Thenine2077/humanoi/docs/AMAZINGHAND.md

# มือ AmazingHand — คู่มือการทำงานและสถานะ

อัปเดต 21 ต.ค. 2026 · มือขวา 8 servo ติดปลายแขนซ้าย (left_link_6) ใช้ในเกมเป่ายิ้งฉุบ ([RPS_GAME.md](RPS_GAME.md))

## สรุปสั้น

| | |
|---|---|
| **ใช้ได้แล้ว** | คุมมือจาก ROS บน Pi, เช็กไฟก่อนขยับ, หา baud เอง, ท่ามือในเกมครบ (ค้อน กระดาษ กรรไกร ง้าง ชูโป้ง ชู 2 นิ้ว ส่ายนิ้ว), เครื่องมือคาลิเบรตทีละนิ้ว, **สอนท่ามือเอง** (`arm hand-teach` จ็อก/ดัดด้วยมือ แล้วบันทึก) ใช้ใน `arm program` / `arm hand` / เกม |
| **ยังติด** | นิ้วมีระยะฟรี, แตร servo น่าจะใส่คลาดหลายฟัน (กำ/แบอาจชนขอบ servo), คาลิเบรตยังไม่เสร็จ, ขีดจำกัด servo ที่อ่านจาก EEPROM ยังไม่ได้ยืนยันกับของจริง |
| **ตอนนี้** | บอร์ดมือเสียบกับ Pi แล้ว (21 ต.ค. บ่าย — แขนซ้าย + Nano + มือ) |

---

## 1. ฮาร์ดแวร์

| ชิ้น | รายละเอียด |
|---|---|
| มือ | AmazingHand (ชุด AliExpress) **มือขวา** 4 นิ้ว |
| servo | Feetech SCS0009 × 8 (model 1284) ลิมิตโรงงาน raw 20–1003 ≈ ±144° |
| ID | นิ้วชี้ 1-2 · กลาง 3-4 · นาง 5-6 · โป้ง 7-8 (ตัวแรกของคู่ = a, ตัวที่สอง = b) |
| บอร์ดต่อ | Waveshare Bus Servo Adapter (A) — CH343 USB `1a86:55d3` serial `5B91044327` · jumper ที่ **B** (USB) |
| พอร์ตบน Pi | `/dev/serial/by-id/usb-1a86_USB_Single_Serial_5B91044327-if00` (เกมหาเองจาก USB ID) |
| baud | ตอนนี้ **250000** (ค่าร้าน) — เคยตั้งเป็น 1 Mbps เมื่อ 29 ก.ย. แต่ 20 ต.ค. เจอกลับเป็น 250000 เอง |
| ไฟ | แหล่งจ่าย **6 V ≥3 A** เข้าช่องไฟของบอร์ด → ที่ servo ได้ 5.1–5.4 V (บอร์ดทำไฟตก ~0.8–1 V) |

**กฎไฟ:** servo **ห้ามเกิน 7.4 V** · บอร์ดเขียนรับ 9–12.6 V แต่ส่งไฟตรงเข้า servo **ห้ามใช้** · ไฟ 5 V ไม่พอ
(servo ได้แค่ 3.9–4.3 V ต่ำกว่า 4.5 V ที่มันยอมทำงาน) · วัดมิเตอร์ที่ช่อง V–G ของบอร์ดก่อนเสียบมือทุกครั้งที่เปลี่ยนแหล่งจ่าย

**ต่อ:** ไฟ 6 V → บอร์ด · jumper B · USB บอร์ด → Pi · เปิดพอร์ตได้ทีละโปรแกรม (เกม / เครื่องมือคาลิเบรต / tools บน Windows)

---

## 2. ซอฟต์แวร์ทำงานยังไง

แพ็กเกจ `ros2_ws/src/humanoi_games` (รันใน container `humanoi_ros` บน Pi)

### amazinghand_node — ตัวคุมมือ (ตัวเดียวที่เปิดพอร์ตมือ)

ตอนเชื่อมต่อทำตามลำดับ ไม่ผ่านขั้นไหน = **ไม่เปิดแรงบิด ไม่ขยับ** แล้วบอกเหตุผลใน log:

1. หาพอร์ตจาก USB ID ของบอร์ด
2. หา baud เอง (ลอง 1 Mbps ก่อน แล้วไล่ค่าอื่น — อ่านอย่างเดียว)
3. servo ต้องตอบครบ 8 ตัว และไฟ **4.8–7.4 V** ทุกตัว
4. อ่านขีดจำกัดมุมจาก EEPROM ของ servo แต่ละตัว (อ่านไม่ได้/ค่าแปลก = ใช้ ±144° แล้วเตือน)
5. สั่งให้ถือท่าปัจจุบันก่อน แล้วค่อยเปิดแรงบิด (นิ้วไม่กระตุก)

หัวข้อ ROS:
- `/hand/gesture` (รับ) ชื่อท่า หรือ `relax` = ปลดแรงบิด · คำสั่งใหม่ตัดท่าเคลื่อนไหวที่ค้างอยู่ทันที
- `/hand/status` (ส่ง) `ready` · `gesture:<ท่า>` · `relaxed` · `error:<เหตุผล>`

เป้าหมายที่เกินขีดจำกัดของ servo ถูกจำกัดไว้ที่ขอบ (เตือนใน log) · ปิดโหนด = ปลดแรงบิดทุกตัว (นิ้วอ่อนลงเป็นกำ)

### มุมนิ้วคิดยังไง

แต่ละนิ้วมี servo 2 ตัว: **หมุนสวนกัน = งอ/เหยียด**, **หมุนไปทางเดียวกัน = เอียง/กาง**

```
servo a = งอ + เอียง + กางเพิ่ม        servo b = -งอ + เอียง + กางเพิ่ม      (องศา)
```

ค่าคาลิเบรตต่อนิ้ว: **แบสุด** (งอตอนแบ), **กำสุด** (งอตอนกำ), **เอียง** (ให้นิ้วตั้งตรง)

### ท่ามือ (`hand_poses.py`)

| ท่า | นิ้วชี้ | นิ้วกลาง | นิ้วนาง | นิ้วโป้ง | ใช้ตอน |
|---|---|---|---|---|---|
| `rock` ค้อน | กำสุด | กำสุด | กำสุด | กำสุด | หุ่นออกค้อน |
| `paper` กระดาษ | แบสุด | แบสุด | แบสุด | แบสุด | หุ่นออกกระดาษ / จบเกม |
| `scissors` กรรไกร | แบ + กาง 25° | แบ − กาง 25° | กำสุด | กำสุด | หุ่นออกกรรไกร |
| `windup` ง้าง | กึ่งกลาง | กึ่งกลาง | กึ่งกลาง | กึ่งกลาง | ตอนเป่า-ยิ้ง |
| `like` ชูโป้ง | กำสุด | กำสุด | กำสุด | แบสุด | หุ่นแพ้ |
| `point` ชี้ | แบสุด | กำสุด | กำสุด | กำสุด | ส่ายนิ้ว |
| `victory` (เคลื่อนไหว) | กรรไกร ↔ หุบ 3 รอบ | | | | — (เกมไม่ได้ใช้แล้ว) |
| `nonono` (เคลื่อนไหว) | ชี้แล้วส่าย ±35° 3 รอบ | | | | หุ่นชนะ / ไม่เห็นมือผู้เล่น |

### hand_calibrate — คาลิเบรตทีละนิ้ว

```bash
arm hand-calibrate            # ปิดเกมก่อน (ใช้พอร์ตเดียวกัน)
arm hand-calibrate --reset    # เริ่มใหม่จากค่าเดโม (ค่าเดิมเปลี่ยนชื่อเป็น .bak-<เวลา>)
```

ตอนเปิดพิมพ์ baud และขีดจำกัดที่อ่านจาก servo ทุกตัว แล้วทีละนิ้ว (นิ้วอื่นกำไว้):

1. **ท่าแบสุด** (เริ่มที่นี่): `+` / `-` แบมาก/น้อย · `l` / `r` เอียงจนนิ้วตั้งตรง
2. กด `c` → **ท่ากำสุด**: `+` / `-` จนปลายนิ้วแตะฝ่ามือพอดี (servo ครางค้าง = เกิน กด `-`)
3. กด `n` → นิ้วถัดไป (บันทึกให้) · `q` บันทึกแล้วออก · `x` ออกไม่บันทึก · ใส่ตัวเลขได้ เช่น `+5`

บรรทัดคำสั่งบอกค่าปัจจุบันและมุม servo จริง เช่น `[นิ้วชี้ · ท่ากำสุด] แบ -94 · กำ +112 · เอียง -20 · servo ID1 +92 ID2 -132`
ถ้าไม่ยอมแก้จะบอกตัวเลข เช่น `servo ID2 ต้องไป -150° แต่หมุนได้ -144..+144°`

ค่าเก็บที่ `/humanoi_ws/src/humanoi_games/config/middle_pos.json` (บน Pi = `~/Humanoi/ros2_ws/src/...`)
— เกมโหลดตอนเปิด (คาลิเบรตแล้วต้องเปิดเกมใหม่) · ไฟล์รูปแบบเก่า (middle_pos) แปลงให้เองโดยท่าไม่เปลี่ยน · ไม่มีไฟล์ = ท่าเหมือนเดโมของ Pollen

### hand_teach — สอนท่ามือเอง (`arm hand-teach`)

ท่าที่คำนวณจากค่าคาลิเบรตดูไม่ดี → จัดท่าเองทีละนิ้วแบบสอนหุ่นยนต์ แล้วบันทึกเป็นชื่อท่า

```bash
arm hand-teach                # บน Pi · ปิด arm player / arm rps / arm hand-calibrate ก่อน (ใช้พอร์ตมือเดียวกัน)
```

| พิมพ์ | ทำอะไร |
|---|---|
| `1` `2` `3` `4` | เลือกนิ้ว ชี้ / กลาง / นาง / โป้ง · `0` = ทุกนิ้ว |
| `+` / `-` | กำ / แบ นิ้วที่เลือก 5° (`+10` = 10°) |
| `l` / `r` | เอียงนิ้วที่เลือก 5° (`l10` = 10°) |
| `free` | ปล่อยนิ้วที่เลือกให้อ่อน — **จับดัดด้วยมือ**ได้ |
| `hold` | ล็อกนิ้วที่ปล่อยไว้ตรงที่ดัด (`save` / จ็อก ล็อกให้เองด้วย) |
| `load <ชื่อ>` | เรียกท่า (ในตัวหรือที่สอนไว้) มาแก้ต่อ — ขยับเร็วเท่าตอนเล่นจริง ใช้ดูว่าใน `arm hand` / เกมจะออกมาแบบไหน |
| `save <ชื่อ>` | บันทึกท่าตอนนี้ · ชื่อภาษาอังกฤษ (a-z 0-9 _) |
| `list` · `del <ชื่อ>` · `q` | ดูท่าที่สอน · ลบ · ออก (นิ้วอ่อนลง) |

- เริ่มที่ท่าที่มือค้างอยู่ตอนเปิด · บรรทัดคำสั่งบอก `ชี้ งอ +20 เอียง +4` ของนิ้วที่เลือก (`(ปล่อย)` = นิ้วอ่อนอยู่)
- **ชื่อเดียวกับท่าในตัว** (`rock` `paper` `scissors` `point` `like` `windup` `victory` `nonono` `fist`) = **ใช้แทนท่าในตัว** ทุกที่ รวมถึงเกมเป่ายิ้งฉุบ · `del` ชื่อนั้น = กลับไปใช้ท่าคำนวณ · `victory` / `nonono` ที่สอนเองเป็นท่านิ่ง
- ชื่อใหม่ (เช่น `ok`, `wave1`) ใช้ใน `arm program` / `arm hand` ได้ทันที · ลบท่าที่ยังใช้ในโปรแกรมไม่ได้
- เก็บใน `programs.yaml` (หัวข้อ `hand_poses` — องศา servo ID 1-8 ตรงๆ) ไฟล์เดียวกับท่าแขน · `arm list` แสดงด้วย
- ตัวคุมมืออ่านไฟล์ใหม่ทุกคำสั่ง — สอนเพิ่มแล้ว**ไม่ต้องรีสตาร์ท** `arm player` / เกม
- ท่าที่สอนเป็นองศา servo ของ**มือตัวนี้** — ถ้าถอดแตร servo ใส่ใหม่หรือเปลี่ยนมือ ต้องสอนใหม่ (ไม่ขึ้นกับค่าคาลิเบรต)
- ถึงขอบที่ servo หมุนได้ (±143) = หยุดที่ขอบแล้วเตือน
- **นิ้วไปต่อไม่ได้** (ชนฝ่ามือ / ชนนิ้วอื่น / สุดทางกลไก) = เตือน `! นิ้วไปต่อไม่ได้: นาง ID5 ค้างที่ +70 (สั่ง +90)` แล้วถือไว้ตรงที่ไปถึง — ท่าที่ `save` จึงเป็นท่าที่นิ้วทำได้จริง เห็นเตือนแล้ว**อย่ากดต่อ**
- ทำไมต้องหยุดดัน: servo ตั้งไว้ว่าโหลดเกิน 80% นานๆ = **ตัดแรงบิดตัวเอง** (unloading condition — อ่านจาก servo 21 ต.ค.) นิ้วนั้นอ่อนไปทุกท่าหลังจากนั้น ท่าเลยดูมั่ว · ตัวคุมมือ (`arm player` / เกม) ก็เช็กแบบเดียวกันทุกท่า: เปิดแรงบิดคืนให้ก่อนทำท่า และนิ้วไหนไปไม่ถึงจะถือไว้ตรงนั้นแล้วเตือนชื่อท่าในหน้าต่าง player
- นิ้วชนฝ่ามือที่ราว ชี้ 106 กลาง 116 นาง 98 โป้ง 122 (วัด 29 ก.ย. เทียบค่ากลางเดโม) — ตัวเลข `งอ` ที่เห็นเป็นมุม servo ดิบ ไม่ใช่มุมนิ้ว แต่ละนิ้วจุดศูนย์ไม่เท่ากัน ดูที่นิ้วจริงเป็นหลัก

### ใช้มือในโปรแกรมแขน (`arm program`)

`arm player` เปิดตัวคุมมือให้ด้วย (ห้ามเปิดพร้อม `arm rps` — ใช้แขนและพอร์ตมือเดียวกัน) แล้วเขียนท่ามือในขั้นของโปรแกรมได้:

```
arm program <ชื่อ> <แขนซ้าย>/<แขนขวา>[/<มือซ้าย>[/<มือขวา>]] ...     (- = ไม่ขยับ, wait=วินาที = รอ)
```

ท่ามือ: `rock` `paper` `scissors` `point` `like` `windup` `victory` `nonono` `fist` `relax` + ท่าที่สอนเอง (`arm hand-teach`)

```bash
arm player                                       # หน้าต่าง 2 (มีตัวคุมมือ) · nohand = ไม่ต่อมือจริง
arm hand rock                                    # ลองท่ามือตรงๆ
arm program grab act1/- -/-/rock act2/-/paper    # แขนไป act1 → มือกำ → แขนไป act2 พร้อมแบมือ
arm show grab                                    # ตารางมีคอลัมน์ มือซ้าย / มือขวา
arm run grab
```

- แขนกับมือในขั้นเดียวกัน**ขยับพร้อมกัน** — อยากให้แขนถึงก่อนแล้วมือค่อยกำ ให้แยกเป็นสองขั้น (`act1/-` แล้ว `-/-/rock`)
- ขั้นถัดไปรอจนแขนถึงและมือทำท่าเสร็จ (ท่านิ่ง 0.6 วินาที, `victory` / `nonono` 1.8 วินาที)
- ช่อง **มือขวา** ทำรอไว้สำหรับมือที่สอง (หัวข้อ `/right_hand/gesture`) — ตอนนี้ยังไม่มีมือ จะเตือนแล้วข้าม
- โปรแกรมเดิม (`<แขนซ้าย>/<แขนขวา>`) ใช้ได้เหมือนเดิม · ในไฟล์ `programs.yaml` ขั้นเป็น `{left: act1, right: still, left_hand: rock}`

### สั่งมือตรงๆ (ทดสอบ)

```bash
docker exec -it humanoi_ros /entrypoint.sh ros2 run humanoi_games amazinghand_node
docker exec humanoi_ros /entrypoint.sh ros2 topic pub --once /hand/gesture std_msgs/msg/String "{data: paper}"
```

เครื่องมือบน Windows (`Desktop\AmazingHand\tools\`, ใช้ตอนเสียบมือเข้า PC): `scan_servos.py` (อ่านอย่างเดียว เช็กไฟ),
`relax.py`, `find_limits.py`, `finger_test.py` — ตั้งค่าเริ่มไว้ 1 Mbps **ต้องใส่ `--baud 250000`** ตอนนี้

---

## 3. ปัญหาที่ยังค้าง

| # | ปัญหา | ผล | ทางแก้ / สถานะ |
|---|---|---|---|
| 1 | **นิ้วมีระยะฟรี** (เจอ 20 ต.ค.) | ตำแหน่งนิ้วไม่ซ้ำเดิม คาลิเบรตแล้วก็ไม่นิ่ง | ขันสกรูแตร servo และข้อต่อก้านนิ้วให้แน่น (ปิดไฟมือก่อน) **ก่อน**คาลิเบรต — ซอฟต์แวร์แก้ไม่ได้ |
| 2 | **แตร servo น่าจะใส่คลาดหลายฟัน** | ท่าตรงของมือนี้ต่างจากมือตัวอย่างมาก (นิ้วกลางต้องงอกลับ ~57°, นิ้วชี้ต้องเอียงเกิน 30°) ช่วงหมุนที่เหลือของ servo น้อย — กำ/แบอาจชนขอบก่อนนิ้วถึง เช่นนิ้วชี้เอียง −20 → servo ID2 ชนขอบที่กำราว +123 | แก้ถาวร: ถอดแตรใส่ใหม่ให้ตรงฟัน (ฟันละ 18°) ค่าคาลิเบรตจะกลับมาใกล้ 0 · ตอนนี้ชดเชยด้วยซอฟต์แวร์ |
| 3 | **คาลิเบรตยังไม่เสร็จ** | ไฟล์ล่าสุด (20 ต.ค. 16:26) = ท่าตรงทุกนิ้ว + กำสุดนิ้วชี้เท่านั้น · ค่าจากรอบหลัง (นิ้วชี้ แบ −94 / กำ +112 / เอียง −20) **ไม่ได้บันทึก** | แก้ข้อ 1 ก่อน แล้วคาลิเบรตใหม่ทั้ง 4 นิ้ว (`--reset` ได้) |
| 4 | ~~ขีดจำกัด servo ที่อ่านจาก EEPROM ยังไม่ได้ยืนยัน~~ | 21 ต.ค. อ่านจากมือจริงได้ −144..+144 ทุกตัว (rustypot 1.13.1 อ่านถูก) | ✓ ปิดแล้ว · แต่ขอบนี้เป็นของ servo ไม่ใช่ของนิ้ว — นิ้วชนก่อนถึงขอบเสมอ (ดู hand_teach) |
| 5 | **baud เปลี่ยนกลับเอง** (1 Mbps → 250000) | เครื่องมือบน Windows ที่ตั้ง 1 Mbps ต่อไม่ติด | โหนด/เครื่องมือบน Pi หาเอง · Windows ใส่ `--baud 250000` · สาเหตุยังไม่ทราบ |
| 6 | **ท่ากรรไกร/ชี้/ส่ายนิ้ว ใช้มุมกางตายตัวของเดโม** (±25°, ±15°, ±35°) | อาจดูไม่สวยกับมือนี้ | ปรับใน `hand_poses.py` หลังคาลิเบรตเสร็จ |
| 7 | **ไฟล์คาลิเบรตอยู่บน Pi เท่านั้น** เป็นของ root ไม่อยู่ใน git | ถ้า SD เสียค่าหาย | สำรองเอง / ดึงกลับ PC ก่อน commit (แบบ programs.yaml) — การ sync จาก PC ไม่ทับไฟล์นี้ |
| 8 | **ไลบรารีลงใน container ที่รันอยู่** (rustypot 1.13.1, mediapipe) | สร้าง container ใหม่ = หาย | `docker/Dockerfile` มีชั้นนี้แล้ว — build image ใหม่ตอนว่าง (คำสั่งลงเองอยู่ใน RPS_GAME.md) |
| 9 | **USB บน Pi เต็ม** (4 ช่อง) | ใช้แขนสองข้าง + มือ + กล้องพร้อมกันไม่ได้ | USB hub มีไฟเลี้ยง · ตอนเล่นเกมใช้แขนซ้าย + Nano + กล้อง + มือ พอดี 4 ช่อง |
| 10 | ตำแหน่ง/มุมยึดมือใน URDF ยังเป็นค่าเดา | มีผลแค่ภาพใน RViz / เช็กชนใน MoveIt | วัดจริงแล้วแก้ใน `ar_dual/urdf` |

---

## 4. ทำถึงไหนแล้ว

| วันที่ | |
|---|---|
| 25 ก.ย. | แกะกล่อง: servo เป็น SCS0009 (บอร์ด YB-MFV02 ที่แถมมาใช้ไม่ได้ — เป็นบอร์ด PWM) |
| 29 ก.ย. | ได้ Waveshare adapter · servo ครบ 8 ตัว ID 1–8 · แก้ไฟตก (ใช้แหล่งจ่ายใหม่) · ตั้ง baud 1 Mbps · เขียน tools (scan, relax, wiggle, finger_test, find_limits, calibrate, rc_jog) · รันเดโมของ Pollen ได้ · วัดมุมนิ้วชนฝ่ามือ (ชี้ 106 กลาง 116 นาง 98 โป้ง 122 เทียบค่ากลางเดโม) · ต่อกล้องมือถือให้มือทำท่าตาม (`Fun thing\robot_hand.py`) |
| 20 ต.ค. | ย้ายมือไป Pi · เขียน `amazinghand_node` (เช็กไฟ, หา baud เอง — เจอ 250000) · เกมเป่ายิ้งฉุบใช้มือจริงได้ · ท่าง้างกำหลวม ค้อนกำสุด · เครื่องมือคาลิเบรตบน Pi (ปรับหลายรอบตามที่ใช้จริง: ขยายช่วง ±60°, รีเซ็ตได้, เหลือแค่ แบสุด/กำสุด/เอียง, อ่านขีดจำกัดจาก servo, แสดงมุม servo จริง) |
| 21 ต.ค. | ท่ามือในโปรแกรมแขน (`arm program` ช่อง 3-4, `arm hand`) · มือใน RViz + มือขวา (ซ้ายกลับด้าน) · **`arm hand-teach`** สอนท่ามือเอง (จ็อก / ปล่อยนิ้วดัดด้วยมือ) ชื่อซ้ำท่าในตัว = ใช้แทน · ลองสอนรอบแรก (wave rock scissors point like) แล้วข้างนอกดูมั่ว: ท่าดันนิ้วเลยที่ไปได้ (กลาง/นางไปถึง ±143 = ขอบ servo) → servo ตัดแรงบิดตัวเอง · เพิ่มเช็กนิ้วไปไม่ถึง (หยุดดัน + เตือน) ทั้งตอนสอนและตอนเล่น, `load` เร็วเท่าตอนเล่น, เปิดแรงบิดคืนทุกท่า |
| ถัดไป | สอน 5 ท่ารอบแรกใหม่ (`load` ทีละท่า → แก้ → `save` ชื่อเดิม) แล้วสอน `paper` `windup` เพิ่ม · ขันนิ้วที่หลวม → เสียบมือกลับเข้า Pi → เปิด `arm hand-calibrate` เช็กบรรทัดขีดจำกัด → คาลิเบรตครบ 4 นิ้ว → ลองในเกม → ปรับท่ากรรไกร/ชี้ถ้าจำเป็น · ระยะยาว: ใส่แตร servo ใหม่ |

---

## 5. ไฟล์ที่เกี่ยวข้อง

| ไฟล์ | |
|---|---|
| `ros2_ws/src/humanoi_games/humanoi_games/amazinghand_node.py` | ตัวคุมมือ |
| `ros2_ws/src/humanoi_games/humanoi_games/hand_poses.py` | ตารางท่ามือ + สูตรคำนวณมุม |
| `ros2_ws/src/humanoi_games/humanoi_games/hand_calibrate.py` | เครื่องมือคาลิเบรต |
| `ros2_ws/src/humanoi_games/humanoi_games/hand_teach.py` | สอนท่ามือเอง |
| `ar_program/config/programs.yaml` (บน Pi) หัวข้อ `hand_poses` | ท่ามือที่สอนเอง |
| `ros2_ws/src/humanoi_games/config/middle_pos.json` (บน Pi) | ค่าคาลิเบรต |
| `docs/RPS_GAME.md` | เกมเป่ายิ้งฉุบ |
| `Desktop\AmazingHand\HANDOFF.md`, `Desktop\AmazingHand\tools\` | งานช่วง ก.ย. บน Windows + เครื่องมือ |
| `Desktop\AmazingHand\repo\` (cad, PythonExample) | ของต้นฉบับ Pollen |
