Thenine2077/humanoi/docs/power_budget.pdf

### สรปุ

กำ ลงัไฟทงั้หนุ่
W ปกติ(รวม) | 170.9 | จากชตี อปุ กรณ์
W สงู สดุ (รวม) | 686.1 | ทกุ อยา่ งท างานหนักพรอ้ มกนั — กรณีแยส่ ดุ
จ านวนคา่ ทยี่ งัตอ้ งวัดจรงิ | 1 | ควรเป็น 0 กอ่ นออกแบบแบต

ไวใ้ชต้ อนออกแบบแบต
แรงดันแบต (V) | 24 | แกไ้ด ้
ประสทิ ธภิ าพ DC-DC เฉลยี่ | 85% | step-down ทั่วไป 80–90%
ความจแุ บต (Ah) | 20 | แกไ้ด ้
ใชไ้ดก้ี่ % ของความจุ | 80% | ไมค่ วรใชจ้นหมด 100%
กระแสจากแบต ปกติ(A) | 8.4
กระแสจากแบต สงู สดุ (A) | 33.6 | BMS ตอ้ งจา่ ยตอ่ เนอื่ งไดม้ ากกวา่ นี้
ใชง้านไดป้ ระมาณ (ชั่วโมง) | 1.9 | คดิ จาก W ปกติ

พอรต์ USB ทตี่ อ้ งตอ่ เขำ้ Pi
Arduino MEGA | 1
D500 LiDAR | 1
Astra Pro | 1
Bus Servo Adapter | 2
AR4 Teensy + Nano (แขนละ 2) | 4
รวม | 9
พอรต์ USB บน Pi 5 | 4
ผล | ตอ้ งใช้USB hub แบบมี ไฟเลยี้ ง

### อปุ กรณ์

อปุ กรณ์ | รบัไฟจำก | V | mA ปกติ (ตอ่ ตวั) | mA สงู สดุ (ตอ่ ตวั) | จำ นวน | W ปกติ (รวม) | W สงู สดุ (รวม) | นบั ใน ยอดรวม | ทมี่ ำของคำ่ | หมำยเหตุ
Motor ZKE2032 | Keyence 24V 6.5A | 24 | 975 | 1,500 | 4 | 93.6 | 144.0 | ใช่ | วดั จรงิ | จอ Keyence วัดรวม 4 ตัวได ้3.9A (÷4 = 975) — จดสภาพตอนวัด: ลอ้บนพนื้ /ยกลอย, ทา่ ไหน, ลกู บดิสดุ ไหม · สงู สดุ 1.5A ตามสเปก
PWM Speed control (HW-687) | Keyence 24V 6.5A | 24 | 0 | 0 | 4 | 0.0 | 0.0 | ไม่ | - | กระแสไหลผา่ นไปมอเตอร์นับในแถวมอเตอรแ์ ลว้
LM2596 (24V → 12V) | Keyence 24V 6.5A | 24 | 175 | 300 | 1 | 4.2 | 7.2 | ใช่ | ประมาณ | ค านวณจากโหลด 12V สองแถวถัดไป ÷ ประสทิ ธภิ าพ 80% (สตู ร ไมต่ อ้ งกรอก)
Encoder YT3806 | LM2596 → 12V | 12 | 50 | 80 | 4 | 2.4 | 3.8 | ไม่ | สเปก | ฉลาก DC 8–24V · ≤80mA ตามรนุ่ ใกลเ้คยี ง · นับรวมในแถว LM2596 แลว้
บอรด์ ออปโต ้DST-1R4P (12V→5V) | LM2596 → 12V | 12 | 40 | 80 | 2 | 1.0 | 1.9 | ไม่ | ประมาณ | LED ฝั่งอนิพุต ~5–10mA ตอ่ ชอ่ ง × 4 ชอ่ ง · นับรวมในแถว LM2596 แลว้
AR4 | อะแดปเตอร์AR4 24V | 24 | 1,000 | 10,000 | 2 | 48.0 | 480.0 | ใช่ | ตอ้ งวดั | 1000 เป็นคา่ เดา — วัดตอนเปิดแขนนงิ่ ๆ และตอนขยับ · สงู สดุ = พกิ ัดอะแดปเตอร์10A
AR4 บอรด์ Teensy 4.1 + Nano (USB) | USB hub (มไีฟเลยี้ ง) | 5 | 150 | 200 | 2 | 1.5 | 2.0 | ใช่ | ประมาณ | แขนละ 2 สาย USB
Raspberry Pi 5 (ตัวเปลา่ ) | แหลง่ จา่ ย Pi 5.1V | 5.1 | 1,000 | 2,000 | 1 | 5.1 | 10.2 | ใช่ | ประมาณ | แหลง่ จา่ ยตอ้ งเป็น 5.1V 5A (USB-C)
Hailo AI HAT | แหลง่ จา่ ย Pi 5.1V | 5.1 | 300 | 500 | 1 | 0.0 | 0.0 | ใช่ | ประมาณ | ถา้ไมไ่ ดต้ ดิ บน Pi ใหแ้กจ้ านวนเป็น 0
Arduino MEGA 2560 | USB hub (มไีฟเลยี้ ง) | 5 | 80 | 100 | 1 | 0.4 | 0.5 | ใช่ | ประมาณ | ไมร่ วม relay (ยา้ย relay ไปแหลง่ จา่ ย 5V แยก)
Flysky FS-SR8 | USB hub (มไีฟเลยี้ ง) | 5 | 50 | 50 | 1 | 0.3 | 0.3 | ใช่ | ประมาณ | รับไฟจากขา 5V ของ Mega ซงึ่ มาจาก USB
D500 LiDAR Kit (STL-19P) | USB hub (มไีฟเลยี้ ง) | 5 | 290 | 290 | 1 | 1.5 | 1.5 | ใช่ | สเปก | Waveshare wiki: 1.45W
Astra Pro Depth Camera | USB hub (มไีฟเลยี้ ง) | 5 | 500 | 500 | 1 | 2.5 | 2.5 | ใช่ | สเปก | Orbbec: ไมเ่ กนิ 2.4–2.5W
Bus Servo Adapter (A) V1.1 + AmazingHand | แหลง่ จา่ ยมอื 6V | 6 | 1,000 | 3,000 | 2 | 12.0 | 36.0 | ใช่ | ประมาณ | มอื ละชดุ · เซอรโ์ ว SCS0009 × 8 · หา้มป้อนเกนิ 7.4V · เซอรโ์ วตอ้ งอา่ น ≥4.8V กอ่ นสงั่ ขยับ
Relay 16 channel | แหลง่ จา่ ย 5V (relay) | 5 | 280 | 300 | 1 | 1.4 | 1.5 | ใช่ | ประมาณ | ~70mA ตอ่ ชอ่ งทตี่ ดิ · ตอนวงิ่ ตดิ พรอ้ มกัน 4 ชอ่ ง (ลอ้ ละ 1)
USB hub (ตัว hub เอง) | USB hub (มไีฟเลยี้ ง) | 5 | 100 | 100 | 1 | 0.5 | 0.5 | ใช่ | ประมาณ | ยังไมไ่ ดซ้ อื้ — ตอ้ งเป็นแบบมอี ะแดปเตอรไ์ ฟของตัวเอง
ฟิวส์+ สวติช์/ E-Stop | - | 0 | 0 | 0 | 1 | 0.0 | 0.0 | ไม่ | - | ไมก่ นิ ไฟ ใสไ่ วใ้หร้ายการครบ
รวม (เฉพำะแถวที่นบั ในยอดรวม = ใช)่ | 170.9 | 686.1

วธิใีช: ้ แกเ้ฉพาะชอ่ งสเีหลอื ง (V, mA, จ านวน) — ชอ่ ง W ค านวณเอง · แถวทกี่ นิ ไฟผา่ นอปุ กรณ์อนื่ แลว้ (เชน่ encoder ผา่ น LM2596) ตัง้ นับในยอดรวม = ไม่ จะไดไ้มน่ ับซา ้

### แหลง่ จา่ ย

แหลง่ จำ่ ย | V | จำ่ ยได้ A ตอ่ ตวั | จำ นวน | จำ่ ยไดร้วม W | โหลดปกติ W | โหลดสงู สดุ W | ใชไ้ป % (สงู สดุ ) | สถำนะ | หมำยเหตุ
Keyence 24V 6.5A | 24 | 6.5 | 1 | 156.0 | 97.8 | 151.2 | 97% | ตงึ | จา่ ยมอเตอร์+ LM2596 · จอแสดงกระแสขาออก
อะแดปเตอร์AR4 24V | 24 | 10 | 2 | 480.0 | 48.0 | 480.0 | 100% | ตงึ | แขนละตัว
LM2596 → 12V | 12 | 2 | 1 | 24.0 | 3.4 | 5.8 | 24% | พอ | พกิดั 3A แตไ่ มม่ ฮีตีซงิกใ์ชต้ อ่ เนอื่ งได ้~2A
แหลง่ จา่ ย Pi 5.1V | 5.1 | 5 | 1 | 25.5 | 5.1 | 10.2 | 40% | พอ | อะแดปเตอร์USB-C 27W
USB hub (มไีฟเลยี้ ง) | 5 | | 1 | 0.0 | 6.6 | 7.2 | | ยังไมม่ ขี อ้ มลู | ยังไมไ่ ดซ้ อื้ — ใส่ A ตามอะแดปเตอรข์ อง hub
แหลง่ จา่ ย 5V (relay) | 5 | | 1 | 0.0 | 1.4 | 1.5 | | ยังไมม่ ขี อ้ มลู | ใส่ A ตามฉลากแหลง่ จา่ ย 5V ทมี่ อี ยู่
แหลง่ จา่ ยมอื 6V | 6 | 3 | 2 | 36.0 | 12.0 | 36.0 | 100% | ตงึ | มอืละตัว · ตอนใชแ้บตเปลยี่ นเป็น step-down ≥5A (XL4015/XL4016)

สถานะ: พอ = ใชไ้มถ่ งึ 80% · ตงึ = 80–100% · ไมพ่ อ = เกนิ 100% (ดจู ากโหลดสงู สดุ ) · ชอื่ ในคอลัมน์A ตอ้ งตรงกบั คอลัมน์รับไฟจาก ในชตี อปุ กรณ์
