Thenine2077/humanoi/ros2_ws/src/humanoi_games/models/README.md

# models

`hand_landmarker.task` — MediaPipe Hand Landmarker (Google), ใช้โดย `rps_vision`
- ที่มา: https://storage.googleapis.com/mediapipe-models/hand_landmarker/hand_landmarker/float16/latest/hand_landmarker.task
  (สำเนาเดียวกับที่ใช้ใน `Desktop\Fun thing`)
- สัญญาอนุญาต: Apache License 2.0
- sha256 `fbc2a30080c3c557093b5ddfc334698132eb341044ccee322ccf8bcf3607cde1`, 7.8 MB
