Thenine2077/humanoi/docs/manual/img/overview-robot-front.png

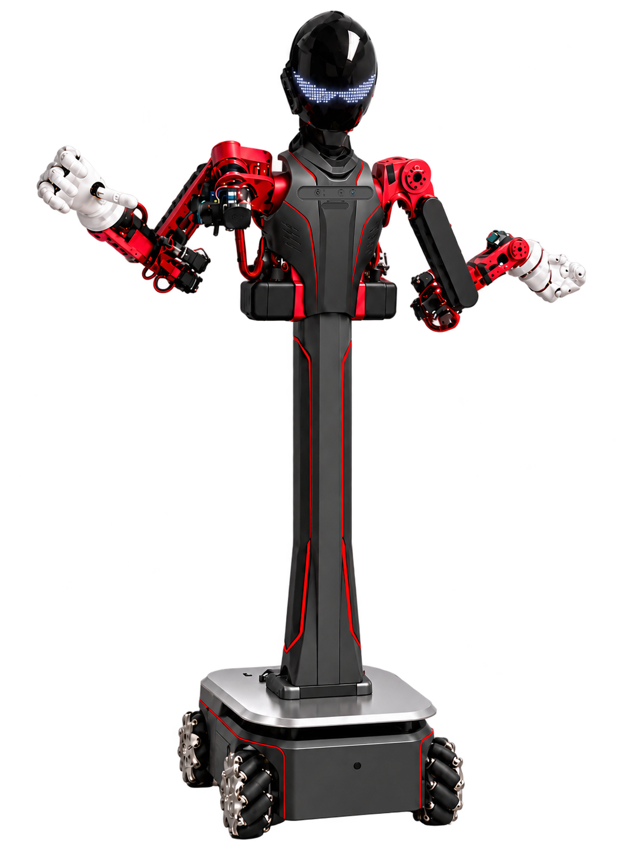
docs/manual/img/overview-robot-front.png
