Thenine2077/humanoi/docs/manual/img/README.txt

รูปสำหรับคู่มือ docs/manual/HUMANOI_MANUAL.html — วางไฟล์ชื่อตามนี้ (.jpg หรือ .png) แล้วเปิดคู่มือใหม่

รูป ปก     cover.jpg                                [รูปถ่าย] หน้าปก
         รูปหุ่นสวยๆ เต็มตัวหรือกำลังทำงาน ภาพแนวตั้งจะพอดีหน้าปกที่สุด
รูป 1.1    overview-robot-front.jpg                 [รูปถ่าย] หุ่น Humanoi ทั้งตัว
         ถ่าย: หุ่นทั้งตัวจากด้านหน้าเฉียง 45° เห็นฐาน แขนสองข้าง มือ และ lidar · ติดป้ายชี้ส่วนประกอบหลัก
รูป 1.3    system-wiring.png                        [แผนผัง] ผังเดินสายทั้งระบบ
         ส่งออกจาก docs/SYSTEM_WIRING.pdf (วาดใน VectorCraft) · แก้ผังแล้วส่งออกใหม่ทับชื่อเดิม
รูป 2.1    safety-exhibition-area.jpg               [รูปถ่าย] การกั้นพื้นที่ในงานจัดแสดง
         ถ่าย: พื้นที่งานจริงที่กั้นเส้นแล้ว เห็นจุด A จุด B ทางวิ่ง และตำแหน่งคนคุมรีโมท
รูป 3.2    pi-connect-terminal.jpg                  [ภาพหน้าจอ] เดสก์ท็อปของ Pi ผ่าน Raspberry Pi Connect พร้อม Terminal
         จับภาพหน้าจอ: หน้าต่าง Screen sharing ของ Raspberry Pi Connect ที่เห็นเดสก์ท็อป Pi · วงกลมไอคอน Terminal (&gt;_) ที่แถบบนซ้าย · มีหน้าต่าง Terminal เปิดอยู่ 1 หน้าต่างพิมพ์ arm status ไว้
รูป 3.3    pi-arm-status.jpg                        [ภาพหน้าจอ] ผลของ arm status ขณะเปิดระบบแขนและตัวเล่นโปรแกรม
         จับภาพหน้าจอ: Terminal บน Pi หลังสั่ง arm status ตอนที่เปิด arm start และ arm player ไว้ · ให้เห็นทั้งบรรทัด ✓ และ ✗ และรายชื่อ controller ท้ายผล · ใช้ Terminal พื้นมืดตัวหนังสือใหญ่พออ่านเมื่อพิมพ์ A4
รูป 3.4    pi-foxglove-connection.jpg               [ภาพหน้าจอ] ต่อ Foxglove บน PC เข้ากับ Pi ที่พอร์ต 8765
         จับภาพหน้าจอ: หน้าต่างเลือกการเชื่อมต่อของ Foxglove บน PC เลือก Foxglove WebSocket ช่อง URL ใส่ ws://EIT-Raspberry-Pi-5.local:8765 · ถ้าได้ ให้ถ่ายคู่กับภาพหลังต่อสำเร็จที่มี Image panel แสดง /tray/image/compressed
รูป 3.5    pi-rebuild-check.jpg                     [ภาพหน้าจอ] ผลของ rebuild_image.sh check เมื่อพร้อมสร้าง image ใหม่
         จับภาพหน้าจอ: Terminal บน Pi หลังสั่ง bash ~/Humanoi/scripts/rebuild_image.sh check · ให้เห็นบรรทัดดิสก์ที่เหลือ, บรรทัด Dockerfile ตรงกับ PC และบรรทัดโปรแกรม ROS ที่รันอยู่
รูป 3.6    pi-usb-devices.jpg                       [รูปถ่าย] Raspberry Pi 5 บนหุ่นและอุปกรณ์ USB ที่ต่ออยู่
         ถ่าย: มุมตรงจากด้านพอร์ต USB ของ Pi 5 (เห็นการ์ด Hailo บนบอร์ดด้วยถ้าทำได้) · ติดป้ายกระดาษที่สายแต่ละเส้น: Teensy แขนซ้าย, Teensy แขนขวา, บอร์ดมือซ้าย/ขวา (Waveshare), กล้อง Astra Pro, Mega ฐานล้อ, lidar · ถ้ามี USB hub ให้เห็นสายไฟเลี้ยงของ hub
รูป 4.1    startup-terminal-windows.jpg             [ภาพหน้าจอ] ตัวอย่างการจัดหน้าต่าง terminal ตอนเล่นภารกิจ
         จับภาพหน้าจอ: หน้าต่าง terminal 6 ช่องที่เปิด arm start / player / tray / lidar / base / mission พร้อมกัน แต่ละช่องเห็นชื่อคำสั่งชัด
รูป 4.2    startup-remote-layout.jpg                [รูปถ่าย] ปุ่มและคันโยกของรีโมทที่ใช้
         ถ่าย: รีโมท FS-ST8 จากด้านหน้า ติดป้าย: คันโยกขวา (เดินหน้า/ถอย, สไลด์), คันโยกซ้าย (หมุน), SWA, SWB, SWD
รูป 5.1    arm-overview-left-right.jpg              [รูปถ่าย] แขนซ้าย (แขน 1) และแขนขวา (แขน 2) เรียกตามด้านของตัวหุ่น
         ถ่าย: หุ่นทั้งตัวจากด้านหลัง (ให้ซ้าย-ขวาของภาพตรงกับซ้าย-ขวาของหุ่น) เห็นแขนทั้งสองบนเสาชัด ติดป้าย "left = แขน 1" ที่แขนซ้าย และ "right = แขน 2" ที่แขนขวา พร้อมลูกศรชี้ทิศ "หน้าหุ่น"
รูป 5.2    arm-joints-j1-j6.jpg                     [แผนผัง] ตำแหน่งข้อต่อ J1–J6 ของแขน AR4 หนึ่งข้าง
         วาด: แขน AR4 หนึ่งข้างแบบเส้นตามที่ติดอยู่บนเสาจริง ระบุ J1 (โคนแขน) J2 (ไหล่) J3 (ศอก) J4 J5 J6 (ข้อมือ) พร้อมลูกศรโค้งบอกแกนหมุนของแต่ละข้อ และวาดมือ AmazingHand ที่ปลาย J6
รูป 5.3    arm-power-switch.jpg                     [รูปถ่าย] สวิตช์ไฟแขน ใช้ตัดไฟเมื่อฉุกเฉิน
         ถ่าย: สวิตช์ไฟแขนบนตัวหุ่น สองภาพ ภาพแรกมุมกว้างให้เห็นว่าอยู่ตรงไหนของหุ่น ภาพที่สองระยะใกล้ให้เห็นตำแหน่งเปิด/ปิด ติดป้าย "สวิตช์ไฟแขน — หยุดฉุกเฉิน"
รูป 5.4    arm-usb-backfeed-check.jpg               [รูปถ่าย] วัดไฟย้อนที่หัว USB-A ของสายแขน ต้องได้ 0V
         ถ่าย: มัลติมิเตอร์ตั้งย่าน DC V สายวัดแตะขาริมสองข้างของหัว USB-A (5V และ GND) หน้าจอมิเตอร์อ่านได้ 0.00 V ระยะใกล้พอเห็นขาในหัว USB ติดป้ายขา "5V" และ "GND"
รูป 5.5    arm-calibrate-limit-switch.jpg           [รูปถ่าย] ลิมิตสวิตช์ของข้อต่อ จุดอ้างอิงตอน calibrate
         ถ่าย: ลิมิตสวิตช์ของข้อต่อหนึ่งข้อ (เช่น J1 ที่โคนแขน) ระยะใกล้ ชี้ให้เห็นตัวสวิตช์และชิ้นส่วนที่หมุนมากดสวิตช์ ติดป้าย "ลิมิตสวิตช์ J1" ถ้าทำได้ ถ่ายอีกภาพของ J6 ด้วย
รูป 5.6    arm-calibrate-output.jpg                 [ภาพหน้าจอ] หน้าจอระหว่าง calibrate แขนซ้ายจนจบ
         จับภาพหน้าจอ: Terminal หลังสั่ง arm calibrate left 6 5 4 1 2 3 จนจบ ให้เห็นกล่องคำเตือน "=== CALIBRATE แขนซ้าย — ลำดับ: 6 5 4 1 2 3 ===" บรรทัด "พร้อมแล้วกด Enter" บรรทัด ✓ J.. เจอสวิตช์แล้ว ครบหกข้อ บรรทัด "calibrate ครบตามที่สั่งแล้ว" บรรทัด → ข้อ .. ไป ... และบรรทัด "เสร็จแล้ว — ..." (ตัดเป็นสองภาพได้ถ้ายาว)
รูป 5.7    arm-start-windows.jpg                    [ภาพหน้าจอ] หน้าต่าง arm start และ arm player ที่เปิดค้างไว้
         จับภาพหน้าจอ: Terminal สองหน้าต่างวางเคียงกัน หน้าต่าง 1 arm start เห็นบรรทัดเช็กค่าชดเชยศูนย์ "... ตรงกับไฟล์ ✓" และ "เปิดระบบแขน (ซ้าย=real @ ... · ขวา=real @ ...)" หน้าต่าง 2 arm player เห็นบรรทัด "เปิดตัวเล่นโปรแกรม speed=0.19 rad/s + ตัวคุมมือ ..." ติดป้าย "หน้าต่าง 1" "หน้าต่าง 2"
รูป 6.1    teach-rviz-joints.jpg                    [ภาพหน้าจอ] RViz กับแผง MotionPlanning: เลือกแขนและเลื่อนมุมข้อต่อ
         จับภาพหน้าจอ: หน้าต่าง RViz เต็มจอบน Pi เห็นโมเดลสองแขน เสา หัว กล้อง และแขนสีส้มโปร่งที่ถูกเลื่อนไว้ต่างจากแขนจริง ไฮไลต์ช่อง Planning Group (เลือก left_arm) และแท็บ Joints ที่มีแถบเลื่อนของแต่ละข้อ ติดป้าย "แขนสีส้ม = ท่าที่จะไป"
รูป 6.2    teach-rviz-plan-execute.jpg              [ภาพหน้าจอ] แท็บ Planning: Velocity Scaling 1.0 ปุ่ม Plan &amp; Execute และปุ่ม Stop
         จับภาพหน้าจอ: แท็บ Planning ของแผง MotionPlanning ระยะใกล้ วงช่อง Velocity Scaling ที่เป็น 1.00 ปุ่ม Plan &amp; Execute และปุ่ม Stop ติดป้ายแต่ละจุด
รูป 6.3    teach-program-timeline.jpg               [แผนผัง] โปรแกรม pick2 เมื่อเล่นจริง: สองแขนเดินไปพร้อมกันทีละขั้น
         วาด: แผนภาพเวลาแนวนอนสองแถว แถวบน "แขนซ้าย" แถวล่าง "แขนขวา" แบ่งเป็น 5 ช่องตามขั้น: 1 rest|rest, 2 act1|act1, 3 act2|แถบจาง "ค้างที่ act1 (-)", 4 กล่อง "wait 1 s" คร่อมสองแถว, 5 rest|rest ระหว่างขั้นวาดเส้นแนวตั้งเขียนว่า "รอทุกแขนถึง" และใส่หมายเหตุใต้ขั้น 3 ว่า "- ไม่ได้กลับ rest"
รูป 6.4    teach-list-output.jpg                    [ภาพหน้าจอ] ผลของ arm list: ท่าของแต่ละแขนและโปรแกรมทั้งหมด
         จับภาพหน้าจอ: Terminal หลังสั่ง arm list เห็นบรรทัดไฟล์ หัวข้อ "ท่าแขนซ้าย (...)" และ "ท่าแขนขวา (...)" พร้อมมุมเป็นองศา และหัวข้อ "โปรแกรม (...)" ที่แสดงขั้นแบบ a/b → c/d ถ้าทำได้ต่อด้วยผล arm show pick2 ด้านล่าง
รูป 6.5    teach-edit-loop.jpg                      [แผนผัง] วงจรแก้ท่า: goto → ปรับใน MoveIt → teach ชื่อเดิม → ลองเล่น
         วาด: วงกลมสี่กล่องต่อกันด้วยลูกศร "arm goto left act1" → "ปรับใน MoveIt (Joints → Plan &amp; Execute)" → "arm teach left act1 (ชื่อเดิม ทับของเดิม)" → "arm run pick2 (ช้าๆ)" แล้ววนกลับกล่องแรก ใส่ข้อความข้างวงว่า "ทุกโปรแกรมที่ใช้ act1 ได้ค่าใหม่ทันที ไม่ต้องรีสตาร์ท"
รูป 6.6    teach-remote-switches.jpg                [รูปถ่าย] สวิตช์บนรีโมท FlySky ที่ใช้สั่งแขน
         ถ่าย: รีโมท FlySky FS-ST8 จากด้านหน้า เห็นสวิตช์ด้านบนทั้งหมด ติดป้ายสวิตช์ที่สั่ง "เล่นโปรแกรม" (ตัวที่ตั้งเป็นช่อง CH6 — SWB หรือ SWC ตามที่ตั้งจริง) "SWD = หยุดแขน" และ "SWA = ARM ล้อ" พร้อมลูกศรบอกทิศ ขึ้น/ลง
รูป 6.7    teach-remote-window.jpg                  [ภาพหน้าจอ] หน้าต่าง arm remote ขณะโยกสวิตช์
         จับภาพหน้าจอ: Terminal ที่เปิด arm remote แล้วโยกสวิตช์จริง ให้เห็นบรรทัด "SWB โยกลง = เล่นโปรแกรม '1' · SWD โยกลง = หยุดแขน" บรรทัด "สวิตช์ SWB=U SWD=U" "สวิตช์ SWB=D SWD=U" "SWB โยกลง -&gt; เล่นโปรแกรม '1'" และ "แขนรายงาน: 1:ok"
รูป 7.1    hand-closeup.jpg                         [รูปถ่าย] มือ AmazingHand ที่ปลายแขน AR4
         รูปถ่ายระยะใกล้ของมือบนปลายแขน เห็นนิ้วทั้งสี่ (ชี้ กลาง นาง โป้ง) และจุดที่ต่อกับข้อ 6
รูป 7.2    hand-servo-ids.jpg                       [แผนผัง] หมายเลข servo ของแต่ละนิ้ว และการหมุนที่ทำให้นิ้วงอหรือเอียง
         วาด: มือมองจากด้านฝ่ามือ ติดเลข ID 1–8 ที่ servo คู่ของแต่ละนิ้ว (ชี้ 1-2, กลาง 3-4, นาง 5-6, โป้ง 7-8) · ภาพเล็กด้านข้างสองภาพ: ลูกศร a กับ b หมุนสวนกัน = นิ้วงอ/เหยียด, ลูกศร a กับ b หมุนทางเดียวกัน = นิ้วเอียง/กาง
รูป 7.3    hand-board-labels.jpg                    [รูปถ่าย] บอร์ด Waveshare Bus Servo Adapter (A) และจุดที่ต้องรู้
         ถ่าย: บอร์ดมองจากด้านบน ตรงๆ แสงพอ · ติดป้าย: ช่องไฟเข้า (6 V), jumper ที่ตำแหน่ง B, ขั้ว V–G สำหรับวัดไฟ, ช่องสาย servo (D V G), พอร์ต USB · แปะสติกเกอร์บนบอร์ดจริงบอกว่าเป็นของแขนไหนพร้อมหมายเลขบอร์ด แล้วให้เห็นในรูป · ถ่ายอีกภาพเป็นมิเตอร์กำลังวัดที่ V–G
รูป 7.4    hand-scan-output.jpg                     [ภาพหน้าจอ] ผลของ arm hand-scan เมื่อมือทั้งสองข้างพร้อมใช้งาน
         จับภาพหน้าจอ: Terminal บน Pi หลังสั่ง arm hand-scan ขณะเสียบบอร์ดมือทั้งสองบอร์ด · ให้เห็นบรรทัดหมายเลขบอร์ด + "มือแขนซ้าย/ขวา", บรรทัด ✓ baud พร้อม ID1–ID8 และค่าไฟ, และบรรทัดสรุปช่วงไฟปลอดภัยท้ายผล · วงสีค่าไฟของ servo หนึ่งตัวไว้อธิบาย
รูป 7.5    hand-builtin-poses.jpg                   [รูปถ่าย] ท่าในตัวของมือ
         ถ่าย: ภาพชุด 8 ช่องเรียงเป็นตาราง 4×2 ฉากหลังเรียบ มุมเดียวกันทุกภาพ (ด้านหน้ามือ ระดับสายตา) ท่า rock, paper, scissors, windup, like, point, victory (จังหวะชูสองนิ้ว), nonono (จังหวะชี้) · ใส่ชื่อท่าใต้แต่ละช่อง · ถ่ายหลังคาลิเบรตเสร็จแล้ว
รูป 7.6    hand-teach-terminal.jpg                  [ภาพหน้าจอ] หน้าต่าง arm hand-teach ระหว่างจัดท่า
         จับภาพหน้าจอ: Terminal บน Pi ระหว่าง arm hand-teach · ให้เห็นบรรทัดช่วยเหลือตอนเปิด, การเลือกนิ้ว 1, คำสั่ง +10, บรรทัดสถานะ "ชี้ งอ … เอียง …", และคำสั่ง save ที่สำเร็จ · ถ้าจับได้ ให้มีบรรทัดเตือน "! นิ้วไปต่อไม่ได้" หนึ่งบรรทัดไว้อธิบาย
รูป 8.1    tray-marker-on-box.jpg                   [รูปถ่าย] ป้าย ArUco id 1 แปะกลางพื้นกล่อง หันด้านบนเข้าหาหุ่น
         ถ่าย: มุมสูงมองลงในกล่อง เห็นทั้งกล่องและป้าย · ใส่ลูกศรบอก "ทางหุ่น" ชี้ไปด้านบนของป้าย · ใส่เส้นบอกขนาด 120 mm ที่ด้านดำ และวงหูกล่องด้านยาวทั้งสองข้าง · ถ้าบนโต๊ะมีเทปหรือที่กั้นตำแหน่งกล่อง ให้เห็นในรูปด้วย
รูป 8.2    tray-detector-view.jpg                   [ภาพหน้าจอ] ภาพจาก arm tray ใน Foxglove: กรอบป้าย แกน และตัวเลขความนิ่ง
         ภาพจาก /tray/image/compressed บรรทัดบน: OK, frames, spread, ตำแหน่งเทียบแขน (arm), ระยะ (dist), reproj
รูป 8.3    tray-teach-touches.jpg                   [แผนผัง] ท่าแตะ: เลื่อนกล่องสองทิศ ข้อมือมุมเดิมทุกครั้ง
         วาด: มุมมองจากด้านบน กล่องตำแหน่งปกติ (เส้นทึบ) และตำแหน่งที่เลื่อนไป 4–5 ตำแหน่ง (เส้นประ) ห่างกัน 3–7 cm ทั้งแนวซ้าย-ขวาและหน้า-หลัง ทุกกล่องหันมุมเดียวกัน · จุดแตะสีแดงที่ตำแหน่งเดียวกันบนกล่องทุกกล่อง · มุมภาพมีปลายนิ้ว/ข้อมือวาดในทิศเดิมทุกครั้ง พร้อมข้อความ "ข้อมือมุมเดิม" และ "ไม่หมุนกล่อง"
รูป 8.4    tray-grip-handle.jpg                     [รูปถ่าย] ท่าจับจริง: นิ้วท่า tray_grip จับหูกล่อง
         ถ่าย: มุมข้างระดับขอบกล่อง ใกล้พอเห็นนิ้วเกี่ยวหูกล่องด้านยาว · ถ่ายคู่อีกภาพเป็นท่า tray_grip0 (นิ้วเตรียม ก่อนจับ) ในมุมเดียวกัน · วางคู่ซ้าย-ขวาพร้อมชื่อท่า
รูป 8.5    tray-pick-sequence.jpg                   [แผนผัง] ลำดับการหยิบห้าขั้นของ arm tray-pick
         วาด: มุมมองด้านข้าง 5 ช่องเรียงซ้ายไปขวา (1) นิ้ว tray_grip0 (2) ข้อมือไปรอเหนือที่จับ 8 cm (3) ลงเส้นตรงตั้งฉากพื้นกล่อง (ลูกศรลง) (4) นิ้ว tray_grip จับหู (5) ยกขึ้นเส้นตรงแล้วค้าง (ลูกศรขึ้น ราว 9–10 cm) · ช่องเล็กท้ายภาพแสดงการวางคืน r ย้อนลำดับ
รูป 8.6    tray-pick-plan.jpg                       [ภาพหน้าจอ] หน้าต่าง arm tray-pick หลังกด Enter: แผนและคำถามยืนยัน
         จับภาพหน้าจอ: Terminal บน Pi ระหว่าง arm tray-pick หลังกด Enter ให้เห็นข้อความแผน และบรรทัด "หยิบเลย? พิมพ์ y แล้ว Enter" · ถ้าได้ ให้ถ่ายอีกภาพเป็นข้อความปฏิเสธ (เช่นกล่องเลื่อนเกิน) ไว้ประกอบหัวข้อเหตุที่ไม่หยิบ
รูป 9.2    base-mega-wiring.jpg                     [รูปถ่าย] Arduino Mega และสายที่ต่อ
         ถ่าย: Mega จากด้านบน เห็นสาย relay (22–29), สายรีโมท (2–9) และสาย encoder (A8–A14) ติดป้ายกลุ่มสาย
รูป 9.3    base-relay-hw687.jpg                     [รูปถ่าย] บอร์ด relay และลูกบิดความเร็ว HW-687 ของแต่ละล้อ
         ถ่าย: บอร์ด relay 8 ช่อง + HW-687 สี่ตัว ติดป้ายว่าลูกบิดไหนคือล้อ FL FR RL RR
รูป 9.4    base-opto-board.jpg                      [รูปถ่าย] บอร์ด opto PC817 ที่แปลงสัญญาณ encoder ให้ Mega
         ถ่าย: บอร์ด opto ใกล้ๆ เห็นขา IN/G ฝั่ง encoder และ V/G ฝั่ง Mega ติดป้ายช่อง 1–4
รูป 9.5    base-wheel-tune-output.jpg               [ภาพหน้าจอ] หน้าจอ wheel-tune ระหว่างจูน
         จับภาพหน้าจอ: arm wheel-tune ที่มีล้อขึ้น ✓ บางล้อ และ เพิ่ม/ลด บางล้อ
รูป 10.1   lidar-mount.jpg                          [รูปถ่าย] lidar บนแผ่นฐานและเสาที่อยู่ข้างหลัง
         ถ่าย: lidar จากด้านข้างและด้านบน เห็นระยะถึงขอบแผ่นหน้า และเสาลำตัวที่อยู่ข้างหลัง
รูป 10.2   lidar-check-bottle.jpg                   [แผนผัง] วางขวดสำหรับ lidar-check
         วาด: ภาพมองจากบน ขวดอยู่หน้าหุ่น 1 m ตรงแนวกลาง (ตลับเมตรจากมุมหน้าซ้าย/ขวาเท่ากัน) และตำแหน่งที่สองข้างซ้ายของหุ่น
รูป 10.3   lidar-foxglove-map.jpg                   [ภาพหน้าจอ] แผนที่ระหว่างทำใน Foxglove
         จับภาพหน้าจอ: Foxglove panel 3D เห็น /map สีเทา จุด /scan และตำแหน่งหุ่น
รูป 11.2   guard-stop-test.jpg                      [รูปถ่าย] ทดสอบกันชน: คนยืนหน้าหุ่น
         ถ่าย: หุ่นหยุดหน้าคน เห็นตลับเมตรวัดระยะจากขอบหน้าฐานถึงหน้าแข้งและปลายเท้า
รูป 12.2   mission-demo-run.jpg                     [รูปถ่าย] ภารกิจ demo_ab ระหว่างฐานวิ่งไป B
         ถ่าย: หุ่นถือกล่องแขนพับ กำลังวิ่งจาก A ไป B เห็นป้าย A และ B บนพื้น
รูป 13.1   rps-setup-overview.jpg                   [รูปถ่าย] การจัดวางสำหรับเกม: หุ่นในท่าตั้ง rps_ready และตำแหน่งผู้เล่น
         ถ่าย: มุมเฉียงจากด้านข้างหุ่น เห็นแขนซ้ายในท่า rps_ready มือท่า windup อยู่หน้ากล้อง, กล้อง Astra บนเสา, โต๊ะหน้าหุ่น และผู้เล่นยื่นมือเหนือโต๊ะ · ถ้ามีจอ HUD ให้เห็นจอด้วย · ติดป้าย: กล้อง, ท่าตั้ง, จุดยื่นมือของผู้เล่น, สวิตช์ไฟแขน
รูป 13.2   rps-round-flow.jpg                       [แผนผัง] ลำดับของหนึ่งตาในเกมเป่ายิ้งฉุบ
         วาด: แผนผังวงรอบ: rps_ready (windup) → เป่า-ยิ้ง-ฉุบ (J1 ขึ้นลง 3 ครั้ง) → ฉุบ (มือออกท่า) → กล้องอ่าน 1.2 s → แยก 4 ทาง: ผู้เล่นชนะ (victory_pose + like), ผู้เล่นแพ้ (lose_pose + nonono), เสมอ (วนกลับไปเป่าใหม่ ≤ 2 ครั้ง), ไม่เห็นมือ (nonono) → ค้าง 3 s แบมือ → กลับผ่าน move_readyP1 → move_readyP2 → rps_ready → รอนิ้วชี้ ≤ 60 s → วนรอบใหม่
รูป 13.3   rps-terminal-windows.jpg                 [ภาพหน้าจอ] สามหน้าต่างของเกม: arm start, arm rps และ arm rps play
         จับภาพหน้าจอ: จัด Terminal 3 หน้าต่างเรียงกันบนจอเดียว (ใส่หัวหน้าต่าง 1/2/3) · หน้าต่าง 3 ให้เห็นบรรทัด "เป่า-ยิ้ง-ฉุบ! ..." และบรรทัดผล "หุ่น: … · ผู้เล่น: … → …" · หน้าต่าง 2 ให้เห็น log บรรทัด "ยกขึ้น = ข้อ 1 …"
รูป 13.4   rps-player-gestures.jpg                  [รูปถ่าย] ท่ามือผู้เล่นที่กล้องอ่านได้ดี
         ถ่าย: จากมุมของกล้องบนเสา (หรือจับจากภาพ /rps/vision/image/compressed) 4 ภาพเรียงกัน: ค้อน, กระดาษ, กรรไกร (ชี้+กลาง), ชูนิ้วชี้ (เล่นใหม่) · ฝ่ามือหันเข้ากล้อง มือเหนือโต๊ะ · เพิ่มภาพที่ห้าเป็นตัวอย่างผิด: มือหันข้าง (ใส่กากบาท)
รูป 13.5   rps-foxglove-hud.jpg                     [ภาพหน้าจอ] Foxglove สอง panel: จอ HUD และภาพที่กล้องอ่านมือ
         จับภาพหน้าจอ: Foxglove บน PC แบ่งจอสองส่วน ซ้าย Image panel /rps/hud/image/compressed ขณะขึ้น YOU WIN! หรือนับ 3-2-1, ขวา Image panel /rps/vision/image/compressed เห็นมือผู้เล่น · ให้เห็นชื่อ topic ที่หัว panel และคะแนนสะสมมุมขวาบนของ HUD
รูป 13.6   rps-show-poses.jpg                       [รูปถ่าย] ท่าโชว์: victory_pose กับมือชูนิ้วโป้ง และ lose_pose กับมือส่ายนิ้ว
         ถ่าย: สองภาพคู่ มุมเดียวกัน (หน้าหุ่นเฉียงเล็กน้อย เห็นทั้งแขนซ้าย) ภาพซ้ายแขนใน victory_pose มือท่า like · ภาพขวาแขนใน lose_pose มือท่า nonono (จังหวะนิ้วชี้เอียง) · ใส่ชื่อท่าใต้ภาพ
