Thenine2077/humanoi/docs/wiring_encoders.md

# Encoder 4 ล้อ → Arduino Mega → ROS

ความเร็วล้อตั้งด้วยลูกบิด HW-687 ล้อละตัว (relay คุมแค่เดิน/ถอย/หยุด) — encoder ไม่ได้คุมความเร็ว
แต่ใช้ **จูนลูกบิดให้ 4 ล้อหมุนเท่ากัน** แล้วปล่อยไว้ และส่ง **feedback ล้อเข้า ROS** (`/wheel_states`, `/wheel_odom`)

```
encoder YT3806 ×4 ──(A/B)──> Mega A8-A15 ──USB "ENC ..."──> relay_bridge (Pi) ──> /wheel_states /wheel_odom /encoder_raw
                                                   <──"W F F F F"──  /cmd_vel หรือ /wheel_cmd (wheel_tune)
```

เฟิร์มแวร์: `firmware/humanoi_base_mega` (ตัวเดิม + encoder) · โหนด: `humanoi_base/relay_bridge.py`, `wheel_tune.py`
ค่าฐาน: `ros2_ws/src/humanoi_base/config/base.yaml`

## ต่อสาย — บอร์ด opto 4 ช่องแผ่นเดียว (ตอนนี้ใช้แบบนี้)

ต่อแค่ **สาย A (เขียว)** ของ encoder ทุกตัว = 4 ช่องพอดี · สายขาว (B) ไม่ต้องต่อ — พันเทปปลายสายกันแตะอะไร
เฟิร์มแวร์ (`ENC_B_WIRED = false`) นับทุกขอบของ A = 720 ต่อรอบ และเอาทิศจากคำสั่ง relay ของล้อนั้นเอง
(สั่งเดินหน้า = นับบวก, สั่งถอย = นับลบ, หยุดแล้วล้อไหลต่อ = ทิศเดิม) — ข้อจำกัด: ล้อถูกดันด้วยมือตอนหยุด ทิศอาจผิด

| บอร์ด opto | ต่อกับ | | บอร์ด opto | ต่อกับ |
|---|---|---|---|---|
| IN1 | E1 (FL) สายเขียว | | OUT1 | Mega A8 |
| IN2 | E2 (FR) สายเขียว | | OUT2 | Mega A10 |
| IN3 | E3 (RL) สายเขียว | | OUT3 | Mega A12 |
| IN4 | E4 (RR) สายเขียว | | OUT4 | Mega A14 |
| G | สายดำ encoder (ลบ 24V) | | VCC / GND | Mega 5V / GND |

> ฐานจริง (wheel-check 28 ต.ค.): สาย FL กับ RR สลับกัน — FL = E4 (A14), FR = E2, RL = E3, RR = E1 (A8)
> → `encoder_map: [3, 1, 2, 0]` ใน `base.yaml` แล้ว ไม่ต้องย้ายสาย

- **แรงดันอินพุตของบอร์ดต้องตรงกับไฟเลี้ยง encoder** (ดูที่พิมพ์บนบอร์ด): รุ่น 24V = เลี้ยง encoder 24V ·
  รุ่น 12V = เลี้ยง encoder 12V ด้วย XL4016 · รุ่น 5V/3.3V ใช้ไม่ได้ (ไฟ LED ในบอร์ดขาด)
- opto บางรุ่นกลับสัญญาณ (เข้าสูง ออกต่ำ) — ไม่เป็นไร นับขอบขึ้น-ลงเหมือนกัน
- อยากได้ทิศจาก encoder จริง (เช่นล้อถูกดัน): เพิ่ม opto อีกแผ่นต่อสายขาว -> A9 A11 A13 A15 แล้วตั้ง
  `ENC_B_WIRED = true` แฟลชใหม่ และ `counts_per_rev: 1440` ใน base.yaml

## ต่อสาย — แบบสาย A+B (ต้องมี opto 8 ช่อง)

| encoder | ล้อ (ตั้งใจ) | A (เขียว) | B (ขาว) | แดง | ดำ |
|---|---|---|---|---|---|
| E1 | FL หน้าซ้าย | A8 | A9 | +24V | GND |
| E2 | FR หน้าขวา | A10 | A11 | +24V | GND |
| E3 | RL หลังซ้าย | A12 | A13 | +24V | GND |
| E4 | RR หลังขวา | A14 | A15 | +24V | GND |

- **ไฟ encoder:** เลี้ยง 24V จากบัสตรงๆ (ผ่านฟิวส์) ทั้ง 4 ตัว — ห้ามใช้ 5V ของ Mega (encoder ต้องการ 8V ขึ้นไป)
  **GND ของ encoder (สายดำ), บัส 24V (−) และ Mega ต้องต่อร่วมกัน**
- **สายสัญญาณ (เขียว/ขาว) ห้ามผ่าน step-down (เช่น XL4016)** — step-down ปล่อยไฟนิ่ง ตัวเก็บประจุในตัวกลืนพัลส์จนนับไม่ได้
  ลดแรงดันสัญญาณด้วยตัวต้านทานแบ่งแรงดัน (หรือบอร์ด opto) แทน

### สัญญาณ: ตัวแบ่งแรงดัน 10kΩ + 2.2kΩ ต่อสายละชุด (8 ชุด)

```
สายเขียว (A) ──[10kΩ]──┬──> ขา Mega (E1 = A8)
                       └─[2.2kΩ]──> GND
สายขาว (B)   ──[10kΩ]──┬──> ขา Mega (E1 = A9)
                       └─[2.2kΩ]──> GND
```

24V × 2.2k / 12.2k ≈ 4.3V — ไม่เกิน 5V ของ Mega และสูงพอให้อ่านเป็น HIGH (ต้องการ ≥ 3V)

- encoder แบบปล่อยแรงดัน (สัญญาณสลับ 0 ↔ 24V) → ใช้ตัวแบ่งนี้
- encoder แบบ **NPN open collector** (ดึงลง GND อย่างเดียว ไม่ปล่อยไฟออก) → ตัวแบ่งทำให้ Mega เห็น LOW ตลอด
  นับไม่ขึ้นเลย (ไม่เสียหาย) → ถอดตัวแบ่ง ต่อสายตรงเข้า Mega ได้ (Mega มี pull-up 5V ในตัว)
- ไม่รู้ว่าเป็นแบบไหน: ใส่ตัวแบ่งไว้ก่อน ปลอดภัยทั้งสองแบบ
- ต่อผิดล้อหรือนับกลับทิศ **ไม่ต้องย้ายสาย** — `arm wheel-check` หาค่า `encoder_map` / `encoder_signs` ให้
- สายสัญญาณเดินห่างสายมอเตอร์/relay ถ้าทำได้ (สัญญาณรบกวนทำให้นับพลาด)

### เช็กชนิดขาออกด้วยมิเตอร์ (ถ้าอยากรู้ก่อนต่อ)

จ่ายไฟ 24V ให้ encoder **โดยยังไม่ต่อสายเขียว/ขาวเข้า Mega** วัดสายเขียว ↔ GND แล้วค่อยๆ หมุนแกน
- ~0V ตลอด = NPN open collector → ต่อตรงเข้า Mega ได้ ไม่ต้องใช้ตัวแบ่ง
- สลับ 0 ↔ 24V = ปล่อยแรงดัน → ต้องใช้ตัวแบ่ง 10k/2.2k ข้างบน

(ทางเลือกแทนตัวแบ่ง: บอร์ด opto 4 ช่อง รุ่นรับ 24V — 8 สาย ใช้ 2 บอร์ด ฝั่งออกต่อ A8–A15 + GND ของ Mega)

### นับยังไง

จานในตัว encoder มี 360 ช่อง แสงลอดช่องทีไร สาย A, B สลับสูง/ต่ำ (A กับ B เหลื่อมกันครึ่งจังหวะ)
Mega นับทุกขอบขึ้น/ลงของทั้ง A และ B = 360 × 4 = 1440 ครั้งต่อรอบ · ทิศดูจากว่า A หรือ B เปลี่ยนก่อน
rpm = Δค่านับ / 1440 / Δt(วินาที) × 60 · ระยะ = รอบ × π × 0.15 m

## แฟลชเฟิร์มแวร์

Mega ตอนนี้เสียบอยู่ที่ Pi — ย้าย USB มาเสียบ PC แล้วอัปโหลดด้วย Arduino IDE (บอร์ด Arduino Mega 2560)
**ปิดไฟมอเตอร์ก่อนอัปโหลด** (relay อาจกระตุกตอนรีเซ็ต) เสร็จแล้วเสียบกลับ Pi

เปิด Serial Monitor 115200 ดูได้เลย: บรรทัดแรก `READY humanoi_base_mega enc=x4` แล้วมี `ENC ...` ทุก 50 ms
หมุนล้อด้วยมือ ค่านับของ encoder ล้อนั้นต้องเปลี่ยน · ตัวเลข 4 ตัวท้าย (นับพลาด) ควรเป็น 0

## ขั้นตอนครั้งแรก

1. **ยกฐานให้ล้อลอยพ้นพื้น** (วางบนกล่อง)
2. หน้าต่าง 1: `arm base noguard` — เปิดค้างไว้ (ยกล้อไม่ต้องใช้ lidar · `arm base` เฉยๆ = กันชน lidar เปิด
   ไม่มี lidar ล้อไม่หมุน — ดู docs/BASE_SAFETY.md)
3. เปิดรีโมท, **SWA ลง**, ปล่อยคันโยก (Mega อยู่โหมด ROS)
4. หน้าต่าง 2: `arm wheel-check`
   - หมุนทีละล้อ FL → FR → RL → RR ล้อละ 2 วิ แล้วถามว่าล้อหมุนไปทางเดินหน้าไหม (ดูด้วยตา ตอบ y/n)
   - ได้ `encoder_map` / `encoder_signs` → ตอบ y บันทึกลง `base.yaml` → **ปิด/เปิด `arm base` ใหม่**
   - ล้อไหนหมุนกลับทาง → แก้ `INVERT` ในเฟิร์มแวร์ (ค่า encoder ที่ได้ใช้ต่อได้)
5. `arm wheel-tune` — 4 ล้อหมุนเดินหน้าค้าง แสดงทุกวินาที เช่น
   ```
   [  5s] FL   60.1 ( -0.4% ✓)  FR   64.0 ( +6.0% ลด)  RL   57.0 ( -5.6% เพิ่ม)  RR   60.5 ( +0.2% ✓)  | เฉลี่ย 60.4 rpm ต่างสุด 11.6%
   ```
   ปรับลูกบิด HW-687 ของล้อที่ขึ้น `ลด` / `เพิ่ม` ทีละนิด รอ 2–3 วิ จนทุกล้อเป็น ✓ (ต่างไม่เกิน ±1.5%) แล้ว Ctrl+C
   - อยากได้ความเร็วตามที่กำหนด: `arm wheel-tune 60` (เทียบกับ 60 rpm แทนค่าเฉลี่ย)
6. `arm wheel-tune back` — เช็กตอนถอยหลังด้วย (มอเตอร์บางตัวเดิน/ถอยเร็วไม่เท่ากัน)
7. วางลงพื้นแล้วเช็กอีกรอบสั้นๆ (มีน้ำหนักกด ความเร็วเปลี่ยน): ขับตรง 2–3 m ดู `/wheel_states`
   หรือ `ros2 run humanoi_base wheel_tune tune --seconds 4` บนพื้นที่โล่ง

## ค่าที่ต้องรู้ก่อนใช้ odometry (`/wheel_odom`)

- `counts_per_rev` = ค่านับต่อ **รอบล้อ** — 1440 ถ้า encoder หมุนรอบเดียวกับล้อ (ต่อแกนตรง)
  ถ้ามีเฟือง/สายพานทดระหว่าง encoder กับล้อ วัดเอง: ทำเครื่องหมายที่ล้อ, `ros2 topic echo /encoder_raw`,
  หมุนล้อด้วยมือ 1 รอบพอดี → ค่านับที่เปลี่ยน = counts_per_rev
- `track` / `wheelbase` / `wheel_radius` ใน `base.yaml` = 0.385 / 0.385 / 0.0725 m (วัด 28 ต.ค.: กว้างนอกล้อ 42.5, ยาว 53, ล้อหนา 4, Ø14.5 cm)
- mecanum ลื่นตอนสไลด์/หมุน odometry จากล้ออย่างเดียวคลาดได้ — ต่อไปค่อยรวมกับ lidar (rf2o) / IMU
  `publish_odom_tf` ปิดไว้ ไม่ให้ชนกับ TF ของ rf2o

## แก้ปัญหา

| อาการ | ดู |
|---|---|
| `wheel-check` บอกไม่มี encoder ไหนนับ | ล้อหมุนไหม — ไม่หมุน = relay/ไฟมอเตอร์/ลูกบิด · หมุน = encoder ไม่มีไฟ 12V / GND ไม่ร่วม / สายหลุด |
| encoder ตัวอื่นนับด้วย | สาย A/B ข้ามล้อ หรือสัญญาณรบกวนจากสายมอเตอร์ |
| `นับพลาด` ขึ้นตอนหมุนเร็ว | สัญญาณช้า (บอร์ด opto) หรือรบกวน → ตั้ง `ENC_EDGES = 2` ในเฟิร์มแวร์ (แล้ว counts_per_rev = 720) |
| `Mega อยู่โหมด RC / DISARMED / NO_SIGNAL` | รีโมทต้องเปิด, SWA ลง, ไม่จับคันโยก |
| rpm ของล้อติดลบตอนเดินหน้า | `encoder_signs` ยังไม่ได้ตั้ง → `arm wheel-check` |
