Thenine2077/humanoi/docs/SYSTEM_WIRING.pdf

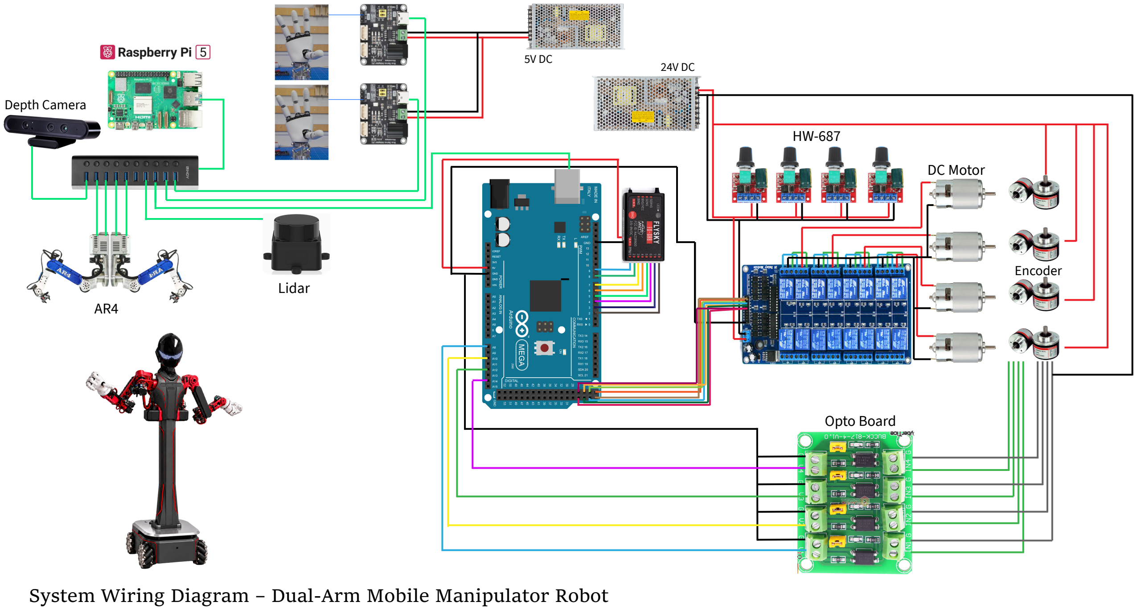
[picture p21: page 1]

24V DC 5V DC

Lidar

Opto Board

HW-687

DC Motor

Encoder

AR4

Depth Camera

System Wiring Diagram – Dual-Arm Mobile Manipulator Robot
