Thenine2077/humanoi/docs/AR4_ARM_MANUAL.pdf

# านแขนกล AR4 สองแขน

## 0 ภาพรวมระบบ

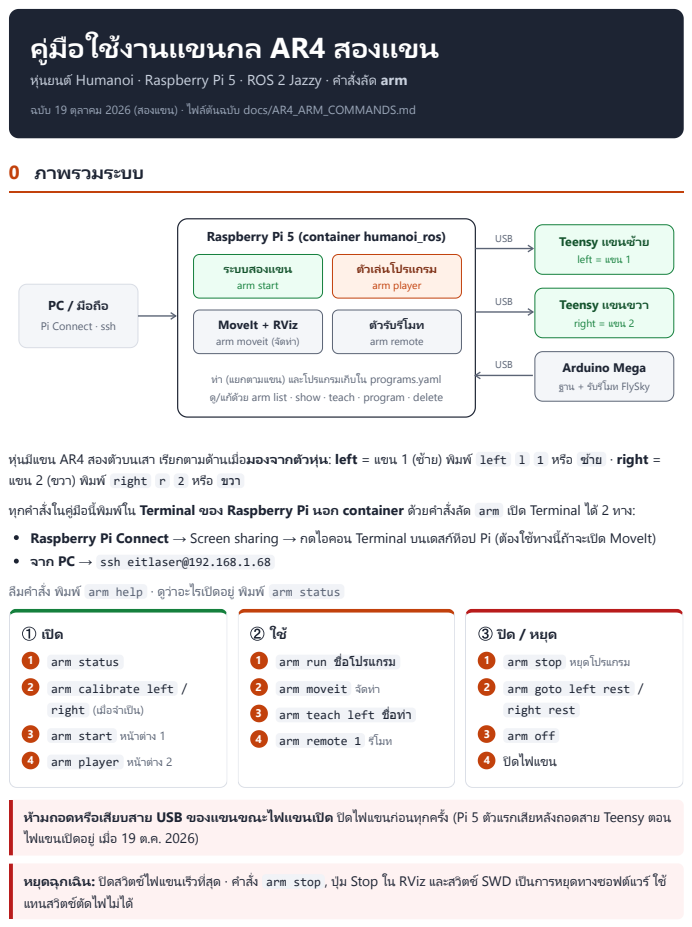
[picture p22: page 1]
ยนต์ Humanoi · Raspberry Pi 5 · ROS 2 Jazzy · คำ สั่งลัดลั; arm; ตุลาคม 2026 (สองแขน) · ไฟ ตุ; นฉต้; บับ docs/AR4_ARM_C บั; OMMANDS.md; ระบบสองแขน arm start; เล่นโปรแกรม; arm player; MoveIt + RViz; arm moveit (จัดจั; arm remote; ย arm list · show · teach · program · delete; USB; Teensy แขนซ้าซ้; left = แขน 1; Teensy แขนขวา; right = แขน 2; Arduino Mega; ฐาน + รับรั; มท FlySky; มีแขน AR4 สอง มี; ตัวบนเสา เ ตั; รียกตาม รี; ด้านเ ด้; มื่อมองจากตัวตั; : left = แขน 1 (ซ้าย) ซ้; left l 1 หรือ รื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

Raspberry Pi 5 (container humanoi_ros)

Pi Connect · ssh

ท่า (แยกตามแขน) และโปรแกรมเก็บใน programs.yaml

จาก PC → ssh eitlaser@192.168.1.68

1 arm status
arm calibrate left /
right (เมื่อจำ เป็น)
3 arm start หน้าต่าง 1
4 arm player หน้าต่าง 2

4 arm remote 1 รีโมท รี

1 arm stop หยุดโปรแกรม
arm goto left rest /
right rest
3 arm off
4 ปิดไฟแขน

## 1 ตั้งค่าครั้งแรก

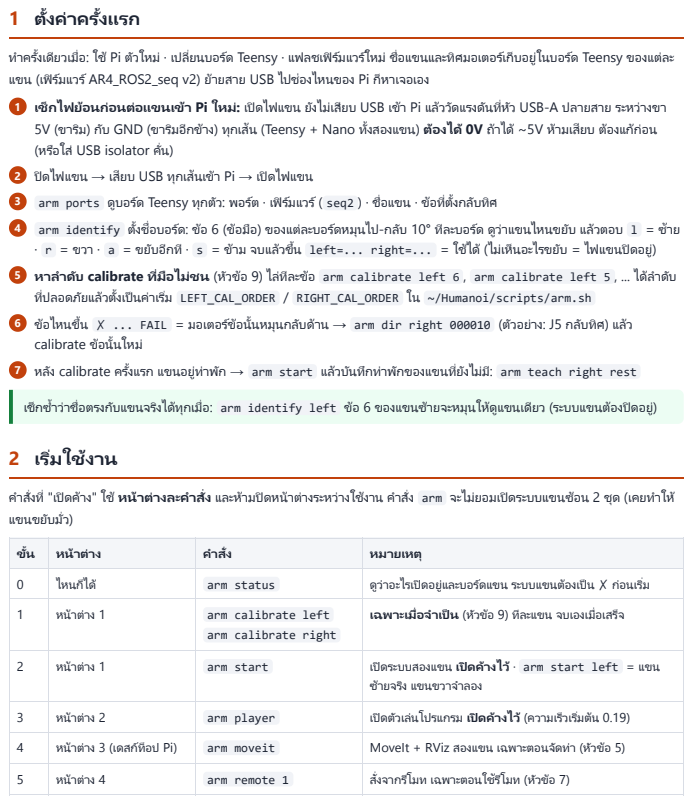
[picture p23: page 2]
ทำ ครั้งเดียวเ ดี; ตัวให ตั; ม่ · เปลี่ยนบอร์ด T ร์; eensy · แฟลชเฟิร์มแว ร์; ร์ใหร์; ม่ ชื่อแขนและทิศมอเตอ ทิ; ร์เร์ก็บอยู่ในบอ ยู่; eensy ของแต่ละ; แขน (เฟิร์มแว ร์; OS2_seq v2) ย้ายสาย USB ไป ย้; ช่องไหนของ Pi ก็หาเจอเอง; เช็กซ้ำ ว่าชื่อตรงกับแขนจ กั; ริงไริ; มื่อ: arm identify left ข้อ 6 ของแขน ข้; ซ้ายจะห ซ้; มุนให้ดูห้; แขนเ ดู; ดียว (ระบบแขน ดี; ต้องต้; ปิดอยู่)ยู่; ช้ หน้าต่างละคำ; สั่ง และห้ามห้; ปิดหน้าต่างระหว่างใช้งาน ช้; คำ สั่ง arm จะไม่ยอมเปิดระบบแขนซ้อน 2 ซ้; ชุด (เคย ชุ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

ขั้นขั้ | หน้าต่าง | คำ สั่ง | หมายเหตุ
0 | ไหนก็ไก็ ด้ | arm status | ดูว่ดู ว่าอะไรเปิดอยู่แยู่ ละบอร์ดร์ แขน ระบบแขนต้อต้ งเป็น ✗ ก่อนเริ่มริ่

1 | หน้าต่าง 1 | arm calibrate left arm calibrate right | เฉพาะเมื่อจำ เป็น (หัวหั ข้อข้ 9) ทีลที ะแขน จบเองเมื่อเสร็จร็

2 | หน้าต่าง 1 | arm start | เปิดระบบสองแขน เปิดค้าค้ งไว้ · arm start left = แขน ซ้าซ้ ยจริงริ แขนขวาจำ ลอง

3 | หน้าต่าง 2 | arm player | เปิดตัวตั เล่นโปรแกรม เปิดค้าค้ งไว้ (ความเร็วร็ เริ่มริ่ ต้นต้ 0.19)
4 | หน้าต่าง 3 (เดสก์ท็ก์ ท็อป Pi) | arm moveit | MoveIt + RViz สองแขน เฉพาะตอนจัดจั ท่า (หัวหั ข้อข้ 5)

5 | หน้าต่าง 4 | arm remote 1 | สั่งจากรีโรี มท เฉพาะตอนใช้รีช้ โรี มท (หัวหั ข้อข้ 7)

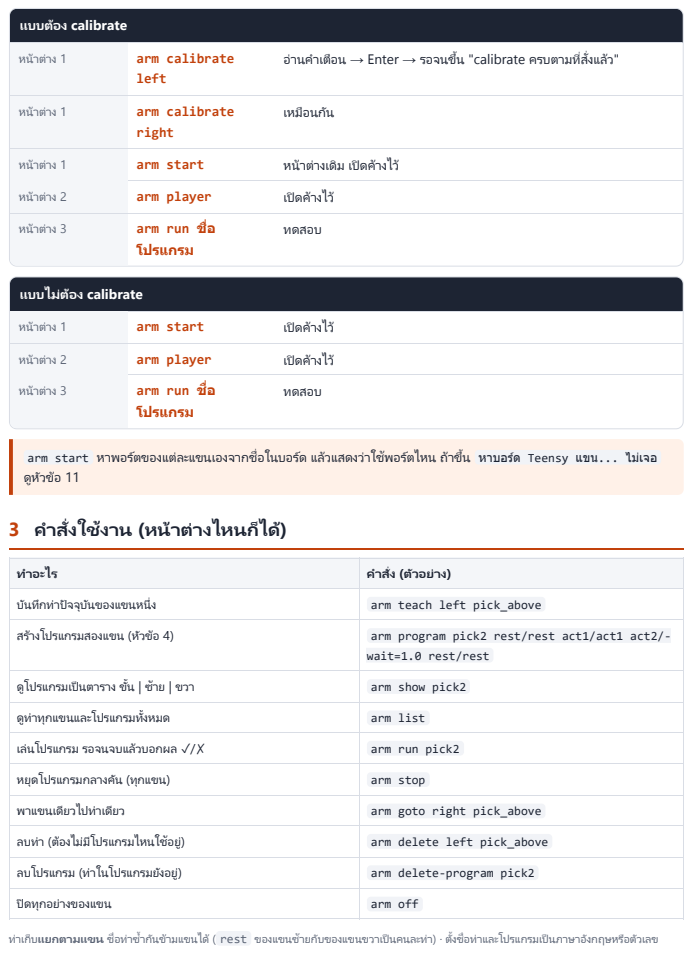
[picture p24: page 3]
แบบต้อง calibrat ต้; arm calibrate; left; อ่านคำ เตือน ตื; → Enter → รอจนขึ้น "calibrat ขึ้; e ครบตามที่สั่ที่; สั่งแล้ว"ล้; right; เหมือนมื; arm start; หน้าต่างเดิม เ ดิ; ปิดค้างไ ค้; arm player; เปิดค้างไ ค้; arm run ชื่อชื่; โปรแกรม; ทดสอบ; แบบไม่ต้ม่; อง calibrat ต้; arm start หาพอร์ตของแ ร์; ต่ละแขนเองจากชื่อในบอร์ด แ ร์; ล้วแสดง ล้; ว่าใช้พอช้; ร์ตไหน ร์; หาบอร์ดร์; Teensy แขน... ไม่เม่; สั่งใช้งช้; าน (หน้าต่างไหนก็ไก็; ท่าเก็บแยกตามแขน ชื่อท่าซ้ำ กันกั; ข้ามแขนไ ข้; rest ของแขนซ้ายซ้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

ทำ อะไร | คำ สั่ง (ตัวตั อย่าย่ ง)

บันบั ทึกทึ ท่าปัจจุบัจุ นบั ของแขนหนึ่ง | arm teach left pick_above

สร้าร้ งโปรแกรมสองแขน (หัวหั ข้อข้ 4) | arm program pick2 rest/rest act1/act1 act2/-wait=1.0 rest/rest

ดูโดู ปรแกรมเป็นตาราง ขั้นขั้ | ซ้าซ้ ย | ขวา | arm show pick2

ดูท่ดู ท่าทุกทุ แขนและโปรแกรมทั้งหมด | arm list
เล่นโปรแกรม รอจนจบแล้วล้ บอกผล ✓/✗ | arm run pick2

หยุดโปรแกรมกลางคันคั (ทุกทุ แขน) | arm stop

พาแขนเดียดี วไปท่าเดียดี ว | arm goto right pick_above

ลบท่า (ต้อต้ งไม่มีโมี ปรแกรมไหนใช้อช้ ยู่)ยู่ | arm delete left pick_above

ลบโปรแกรม (ท่าในโปรแกรมยังยั อยู่)ยู่ | arm delete-program pick2

ปิดทุกทุ อย่าย่ งของแขน | arm off

## 4 เขียขี นโปรแกรมสองแขน

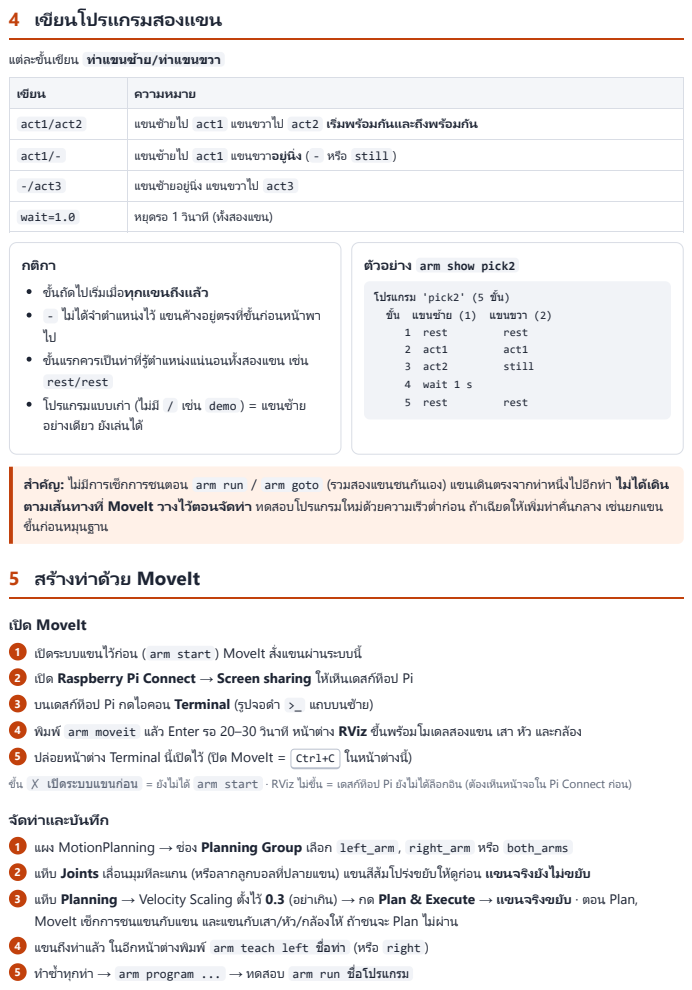
[picture p25: page 4]
แต่ละขั้นเ ขั้; แขนซ้าซ้; แขนขวา; ถัดไปเ ถั; มื่อทุกแขน ทุ; ถึงแถึ; - ไม่ได้จำด้; ตำ แหน่งไว้ แขน ว้; ค้างอ ค้; ยู่ตรง ยู่; ก่อนหน้าพา; ขั้นแรกควรเ ขั้; ป็นท่าที่รู้ตำรู้; แหน่งแน่นอนทั้งสองแขน เช่น; rest/rest; โปรแกรมแบบเก่า (ไม่มี; / เช่น demo ) = แขนซ้ายซ้; อย่างเ ย่; ยังเยั; ล่นได้; ง arm show pick2; โปรแกรม 'pick2' (5 ขั้นขั้; ย (1) แขนขวา (2); 1 rest; rest; 2 act1; act1; 3 act2; still; 4 wait 1 s; 5 rest; ไม่มีการเ มี; ช็กการชนตอน arm run / arm goto (รวมสองแขนชนกันเอง) แขนเ กั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

เขียขี น | ความหมาย

act1/act2 | แขนซ้าซ้ ยไป act1 แขนขวาไป act2 เริ่มริ่ พร้อร้ มกันกั และถึงถึ พร้อร้ มกันกั

act1/- | แขนซ้าซ้ ยไป act1 แขนขวาอยู่นิ่ยู่ นิ่ง ( - หรือรื still )

-/act3 | แขนซ้าซ้ ยอยู่นิ่ยู่ นิ่ง แขนขวาไป act3

wait=1.0 | หยุดรอ 1 วินวิ าที (ทั้งสองแขน)

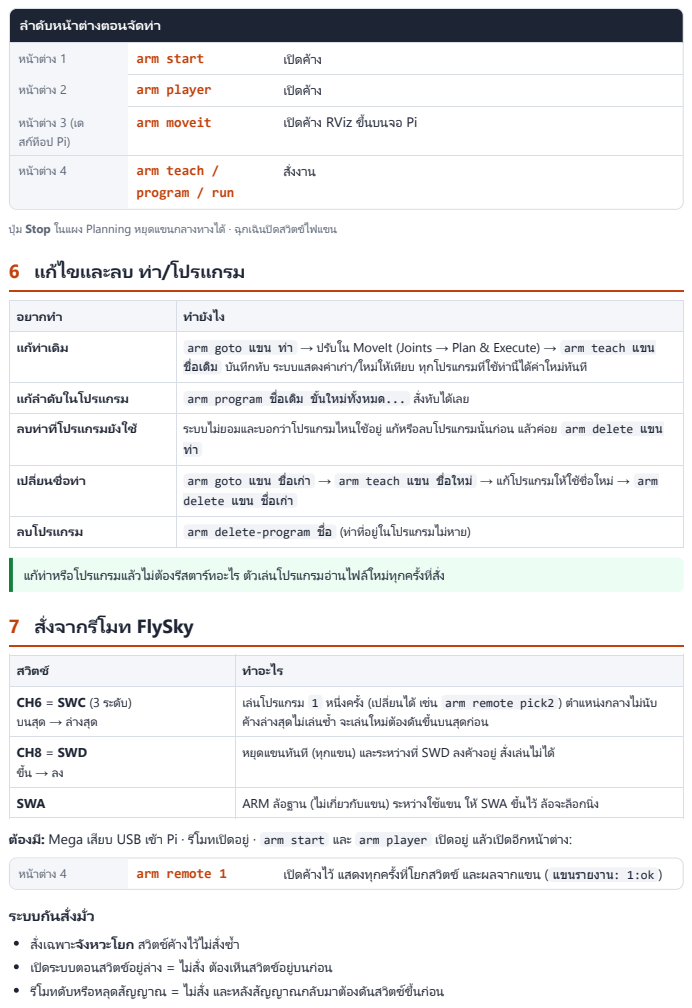
[picture p26: page 5]
ดับหดั; น้าต่างตอนจัดจั; arm start; เปิดค้างค้; arm player; arm moveit; เปิดค้าง RViz ค้; ขึ้นบนจอ Pi ขึ้; arm teach /; program / run; สั่งงาน; ปุ่ม Stop ในแผง Planning หยุดแขนกลางทางได้ · ด้; ฉุกเฉินปิดสวิตวิ; ช์ไฟแขน ช์; ขและลบ ท่าท่; /โปรแกรม; ท่าหรือโปรแกรมแ รื; ล้วไล้; ม่ต้องต้; รีสตา รี; ร์ทอะไร ร์; ล่นโปรแกรมอ่านไฟล์ใหล์; ม่ทุกคทุ; 7 สั่งจากรีโรี; มท FlySky; ต้องต้; Mega เสียบ USB เ สี; รีโมทเ รี; ปิดอยู่ · ยู่; arm start และ arm player เปิดอยู่ แยู่; ล้วเล้; ปิดอีกหอี; arm remote 1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

อยากทำ | ทำ ยังยั ไง

แก้ท่ก้ าท่ เดิมดิ | arm goto แขน ท่าท่ → ปรับรั ใน MoveIt (Joints → Plan & Execute) → arm teach แขน ชื่อชื่ เดิมดิ บันบั ทึกทึ ทับทั ระบบแสดงค่าเก่า/ใหม่ให้เห้ ทียที บ ทุกทุ โปรแกรมที่ใช้ท่ช้ ท่านี้ได้ค่ด้ ค่าใหม่ทันทั ที

แก้ลำก้ ลำ ดับดั ในโปรแกรม | arm program ชื่อชื่ เดิมดิ ขั้นขั้ ใหม่ทั้ม่ งทั้ หมด... สั่งทับทั ได้เด้ ลย
ลบท่าท่ ที่โปรแกรมยังยั ใช้ | ระบบไม่ยอมและบอกว่าโปรแกรมไหนใช้อช้ ยู่ แก้หก้ รือรื ลบโปรแกรมนั้นก่อน แล้วล้ ค่อย arm delete แขน ท่าท่

เปลี่ยลี่ นชื่อท่าท่ | arm goto แขน ชื่อชื่ เก่าก่ → arm teach แขน ชื่อชื่ ใหม่ → แก้โก้ ปรแกรมให้ให้ ช้ชื่ช้ ชื่อใหม่ → arm delete แขน ชื่อชื่ เก่าก่

ลบโปรแกรม | arm delete-program ชื่อชื่ (ท่าที่อที่ ยู่ใยู่ นโปรแกรมไม่หาย)

สวิตวิ ช์ | ทำ อะไร

CH6 = SWC (3 ระดับดั ) บนสุดสุ → ล่างสุดสุ | เล่นโปรแกรม 1 หนึ่งครั้ง (เปลี่ยนได้ เช่น arm remote pick2 ) ตำ แหน่งกลางไม่นับ ค้าค้ งล่างสุดสุ ไม่เล่นซ้ำ จะเล่นใหม่ต้อต้ งดันดั ขึ้นขึ้ บนสุดสุ ก่อน

CH8 = SWD ขึ้นขึ้ → ลง | หยุดแขนทันทั ที (ทุกทุ แขน) และระหว่างที่ SWD ลงค้าค้ งอยู่ สั่งเล่นไม่ได้

SWA | ARM ล้อล้ ฐาน (ไม่เกี่ยวกับกั แขน) ระหว่างใช้แช้ ขน ให้ SWA ขึ้นขึ้ ไว้ ล้อล้ จะล็อกนิ่ง

## 8 ปิดระบบ

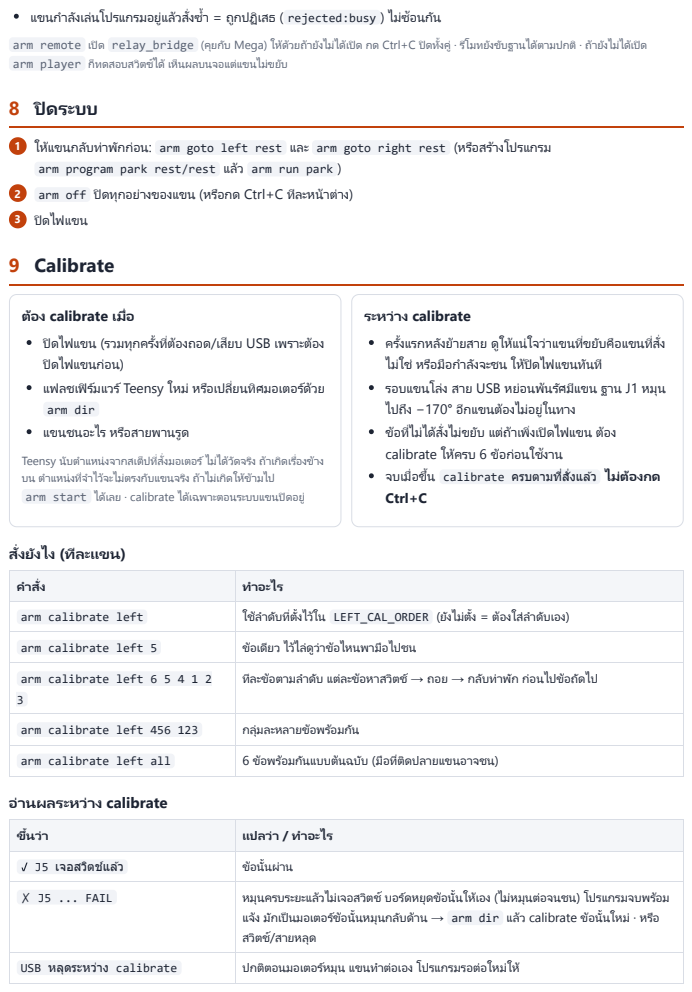
[picture p27: page 6]
แขนกำ ลังเลั; ล่นโปรแกรมอยู่แยู่; = ถูกปถู; ฏิเสธ ( ฏิ; rejected:busy ) ไม่ซ้อนซ้; arm remote เปิด relay_bridge (คุยคุ; กับ Mega) ใ กั; วยด้; ยังไยั; ปิด กด Ctrl+C ปิดทั้งคู่ · คู่; รีโมท รี; ขับฐานไ ขั; ด้ตามปก ด้; arm player ก็ทดสอบสวิตวิ; ห็นผลบนจอแต่แขนไม่ขยับยั; 9 Calibrate; ง calibrate เมื่อ; ปิดไฟแขน (รวมทุกคทุ; องถอด/เ ต้; สียบ USB เ สี; พราะต้องต้; ปิดไฟแขนก่อน); แฟลชเฟิร์มแว ร์; eensy ใหม่ หรือเรื; ปลี่ยนทิศมอเตอ ทิ; arm dir; แขนชนอะไร หรือสายพาน รื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

ระหว่าง calibrate

บน ตำ แหน่งที่จำที่

คำ สั่ง | ทำ อะไร

arm calibrate left | ใช้ลำช้ ลำ ดับดั ที่ตั้ที่ ตั้งไว้ใว้ น LEFT_CAL_ORDER (ยังยั ไม่ตั้ง = ต้อต้ งใส่ลำ ดับดั เอง)
arm calibrate left 5 | ข้อข้ เดียดี ว ไว้ไว้ ล่ดูว่ดู ว่าข้อข้ ไหนพามือมื ไปชน

arm calibrate left 6 5 4 1 2 3 | ทีลที ะข้อข้ ตามลำ ดับดั แต่ละข้อข้ หาสวิตวิ ช์ → ถอย → กลับลั ท่าพักพั ก่อนไปข้อข้ ถัดถั ไป

arm calibrate left 456 123 | กลุ่มลุ่ ละหลายข้อข้ พร้อร้ มกันกั

arm calibrate left all | 6 ข้อข้ พร้อร้ มกันกั แบบต้นต้ ฉบับบั (มือมื ที่ติที่ ดติ ปลายแขนอาจชน)

ขึ้นขึ้ ว่า | แปลว่า / ทำ อะไร

✓ J5 เจอสวิตวิ ช์แช์ ล้วล้ | ข้อข้ นั้นผ่าน
✗ J5 ... FAIL | หมุนครบระยะแล้วล้ ไม่เจอสวิตวิ ช์ บอร์ดร์ หยุดข้อข้ นั้นให้เห้ อง (ไม่หมุนต่อจนชน) โปรแกรมจบพร้อร้ ม แจ้งจ้ มักมั เป็นมอเตอร์ข้ร์ อข้ นั้นหมุนกลับลั ด้าด้ น → arm dir แล้วล้ calibrate ข้อข้ นั้นใหม่ · หรือรื สวิตวิ ช์/ช์ สายหลุดลุ

USB หลุดลุ ระหว่าว่ ง calibrate | ปกติตติ อนมอเตอร์หร์ มุน แขนทำ ต่อเอง โปรแกรมรอต่อใหม่ให้

10 ค่าที่ตั้ที่ | ตั้งไว้แว้ | ละความปลอดภัยภั

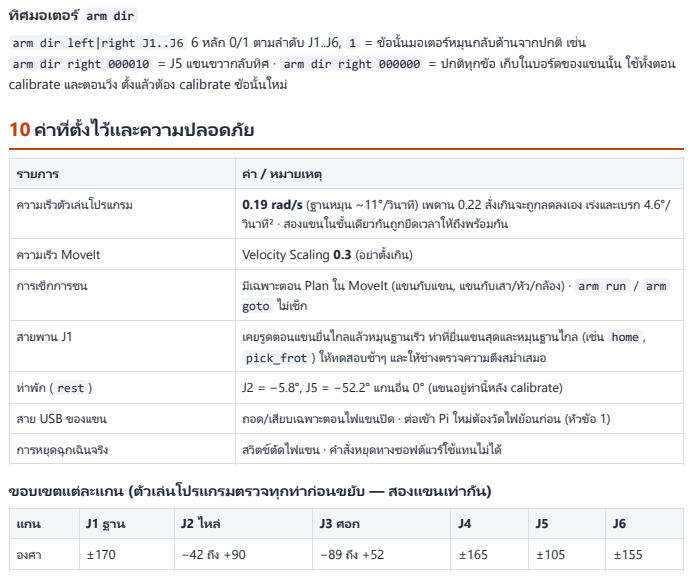
[picture p28: page 7]
มอเตอร์ arm dir; arm dir left|right J1..J6 6 หลัก 0/1 ตาม ลั; นั้นมอเตอร์หร์; มุนกลับลั; ด้านจากปก ด้; arm dir right 000010 = J5 แขนขวากลับลั; arm dir right 000000 = ปกติทุติ; ก็บในบอร์ดของแขน ร์; ทั้งตอน; calibrate และตอนวิ่ง วิ่; ตั้งแล้วล้; ต้อง calibrat ต้; นั้นใหม่; ขอบเขตแต่ละแกน (ตัวตั; เล่นโปรแกรมตรวจทุกทุ; ก่อนขยับยั; — สองแขนเท่าท่

รายการ | ค่า / หมายเหตุ
ความเร็วร็ ตัวตั เล่นโปรแกรม | 0.19 rad/s (ฐานหมุน ~11°/วินวิ าที)ที เพดาน 0.22 สั่งเกินกิ จะถูกถู ลดลงเอง เร่งร่ และเบรก 4.6°/ วินวิ าที² ที · สองแขนในขั้นขั้ เดียดี วกันกั ถูกถู ยืดยื เวลาให้ถึห้ งถึ พร้อร้ มกันกั

ความเร็วร็ MoveIt | Velocity Scaling 0.3 (อย่าย่ ตั้งเกินกิ )

การเช็กการชน | มีเมี ฉพาะตอน Plan ใน MoveIt (แขนกับกั แขน, แขนกับกั เสา/หัวหั /กล้อล้ ง) · arm run / arm goto ไม่เช็ก

สายพาน J1 | เคยรูดรู ตอนแขนยื่นไกลแล้วล้ หมุนฐานเร็วร็ ท่าที่ยื่ที่ ยื่นแขนสุดสุ และหมุนฐานไกล (เช่น home , pick_frot ) ให้ทห้ ดสอบช้าช้ ๆ และให้ช่ห้ ช่างตรวจความตึงตึ สม่ำ เสมอ

ท่าพักพั ( rest ) | J2 = −5.8°, J5 = −52.2° แกนอื่น 0° (แขนอยู่ท่ยู่ ท่านี้หนี้ ลังลั calibrate)

สาย USB ของแขน | ถอด/เสียสี บเฉพาะตอนไฟแขนปิด · ต่อเข้าข้ Pi ใหม่ต้อต้ งวัดวั ไฟย้อย้ นก่อน (หัวหั ข้อข้ 1)
การหยุดฉุกเฉินจริงริ | สวิตวิ ช์ตัช์ ดตั ไฟแขน · คำ สั่งหยุดทางซอฟต์แต์ วร์ใร์ ช้แช้ ทนไม่ได้

แกน | J1 ฐาน | J2 ไหล่ | J3 ศอก | J4 | J5 | J6
องศา | ±170 | −42 ถึงถึ +90 | −89 ถึงถึ +52 | ±165 | ±105 | ±155

## 11 แก้ปัก้ปัญหา

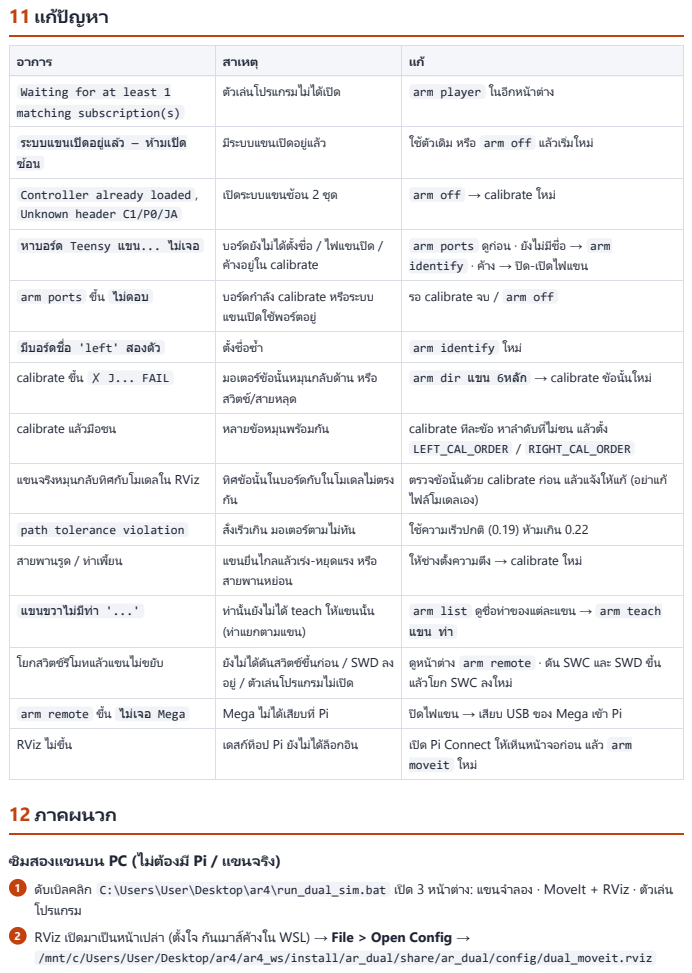
[picture p29: page 8]
12 ภาคผนวก; สองแขนบน PC (ไม่ต้ม่; งมี Pi / แขนจริงริ; บิลคบิ; C:\Users\User\Desktop\ar4\run_dual_sim.bat เปิด 3 หน้าต่าง: แขนจำ ลอง · MoveIt + RViz · ตัวเ ตั; RViz เปิดมาเป็นหน้าเปล่า (ตั้งใจ กันเมา กั; างใน WSL) ค้; → File > Open Config →

อาการ | สาเหตุ | แก้

Waiting for at least 1 matching subscription(s) | ตัวตั เล่นโปรแกรมไม่ได้เด้ ปิด | arm player ในอีกอี หน้าต่าง

ระบบแขนเปิดอยู่แยู่ ล้วล้ — ห้าห้ มเปิด ซ้อซ้ น | มีรมี ะบบแขนเปิดอยู่แยู่ ล้วล้ | ใช้ตัช้ วตั เดิมดิ หรือรื arm off แล้วล้ เริ่มริ่ ใหม่

Controller already loaded , Unknown header C1/P0/JA | เปิดระบบแขนซ้อซ้ น 2 ชุดชุ | arm off → calibrate ใหม่

หาบอร์ดร์ Teensy แขน... ไม่เม่ จอ | บอร์ดร์ ยังยั ไม่ได้ตั้ด้ ตั้งชื่อ / ไฟแขนปิด / ค้าค้ งอยู่ใยู่ น calibrate | arm ports ดูก่ดู ก่อน · ยังยั ไม่มีชื่มี ชื่อ → arm identify · ค้าค้ ง → ปิด-เปิดไฟแขน

arm ports ขึ้นขึ้ ไม่ตม่ อบ | บอร์ดร์ กำ ลังลั calibrate หรือรื ระบบ แขนเปิดใช้พช้ อร์ตร์ อยู่ | รอ calibrate จบ / arm off

มีบมี อร์ดร์ ชื่อชื่ 'left' สองตัวตั | ตั้งชื่อซ้ำ | arm identify ใหม่
calibrate ขึ้นขึ้ ✗ J... FAIL | มอเตอร์ข้ร์ อข้ นั้นหมุนกลับลั ด้าด้ น หรือรื สวิตวิ ช์/ช์ สายหลุดลุ | arm dir แขน 6หลักลั → calibrate ข้อข้ นั้นใหม่

calibrate แล้วล้ มือมื ชน | หลายข้อข้ หมุนพร้อร้ มกันกั | calibrate ทีลที ะข้อข้ หาลำ ดับดั ที่ไม่ชน แล้วล้ ตั้ง LEFT_CAL_ORDER / RIGHT_CAL_ORDER

แขนจริงริ หมุนกลับลั ทิศทิ กับกั โมเดลใน RViz | ทิศทิ ข้อข้ นั้นในบอร์ดร์ กับกั ในโมเดลไม่ตรง กันกั | ตรวจข้อข้ นั้นด้วด้ ย calibrate ก่อน แล้วล้ แจ้งจ้ ให้แห้ ก้ (อย่าย่ แก้ ไฟล์โล์ มเดลเอง)

path tolerance violation | สั่งเร็วร็ เกินกิ มอเตอร์ตร์ ามไม่ทันทั | ใช้คช้ วามเร็วร็ ปกติ (0.19) ห้าห้ มเกินกิ 0.22

สายพานรูดรู / ท่าเพี้ยพี้ น | แขนยื่นไกลแล้วล้ เร่งร่ -หยุดแรง หรือรื สายพานหย่อย่ น | ให้ช่ห้ ช่างตั้งความตึงตึ → calibrate ใหม่

แขนขวาไม่มีม่ ท่มี าท่ '...' | ท่านั้นยังยั ไม่ได้ teach ให้แห้ ขนนั้น (ท่าแยกตามแขน) | arm list ดูชื่ดู ชื่อท่าของแต่ละแขน → arm teach แขน ท่าท่

โยกสวิตวิ ช์รีช์ โรี มทแล้วล้ แขนไม่ขยับยั | ยังยั ไม่ได้ดัด้ นดั สวิตวิ ช์ขึ้ช์ ขึ้นขึ้ ก่อน / SWD ลง อยู่ / ตัวตั เล่นโปรแกรมไม่เปิด | ดูหดู น้าต่าง arm remote · ดันดั SWC และ SWD ขึ้นขึ้ แล้วล้ โยก SWC ลงใหม่

arm remote ขึ้นขึ้ ไม่เม่ จอ Mega | Mega ไม่ได้เด้ สียสี บที่ Pi | ปิดไฟแขน → เสียสี บ USB ของ Mega เข้าข้ Pi
RViz ไม่ขึ้นขึ้ | เดสก์ท็ก์ ท็อป Pi ยังยั ไม่ได้ล็ด้ล็อกอินอิ | เปิด Pi Connect ให้เห้ ห็นหน้าจอก่อน แล้วล้ arm moveit ใหม่

โปรแกรม
/mnt/c/Users/User/Desktop/ar4/ar4_ws/install/ar_dual/share/ar_dual/config/dual_moveit.rviz

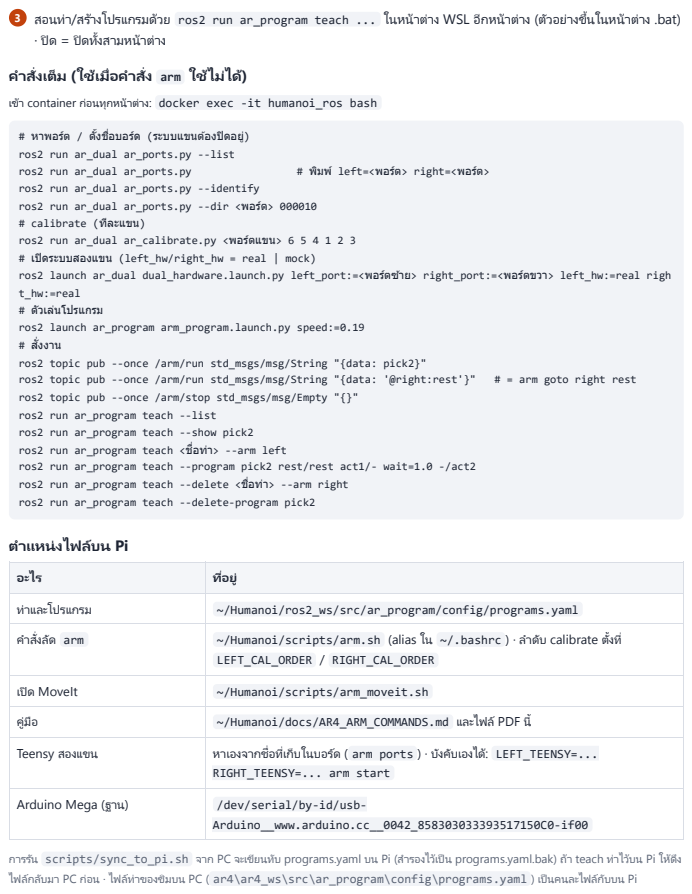
[picture p30: page 9]
สั่งเต็ม (ใช้เช้; มื่อคำ; สั่ง arm ใช้ไช้; เข้า container ข้; ก่อนทุกหทุ; น้าต่าง: docker exec -it humanoi_ros bash; # หาพอร์ตร์; บอร์ดร์; (ระบบแขนต้อต้; งปิดอยู่)ยู่; ros2 run ar_dual ar_ports.py; พ์ left=<พอร์ตร์; > right=<พอร์ตร์; ros2 run ar_dual ar_ports.py --dir <พอร์ตร์; # calibrate (ทีลที; ะแขน); ros2 run ar_dual ar_calibrate.py <พอร์ตร์; แขน> 6 5 4 1 2 3; ros2 launch ar_dual dual_hardware.launch.py left_port:=<พอร์ตร์; ย> right_port:=<พอร์ตร์; ขวา> left_hw:=real righ; โปรแกรม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

· ปิด = ปิดทั้งสามหน้าต่าง

ros2 run ar_dual ar_ports.py --list
ros2 run ar_dual ar_ports.py --identify
# เปิดระบบสองแขน (left_hw/right_hw = real | mock)
t_hw:=real
ros2 launch ar_program arm_program.launch.py speed:=0.19
# สั่งสั่ งาน
ros2 topic pub --once /arm/run std_msgs/msg/String "{data: pick2}"
ros2 topic pub --once /arm/stop std_msgs/msg/Empty "{}"
ros2 run ar_program teach --list
ros2 run ar_program teach --show pick2
ros2 run ar_program teach --program pick2 rest/rest act1/- wait=1.0 -/act2
ros2 run ar_program teach --delete-program pick2

ตำ แหน่งไฟล์บน Pi

อะไร | ที่อที่ ยู่

ท่าและโปรแกรม | ~/Humanoi/ros2_ws/src/ar_program/config/programs.yaml

คำ สั่งลัดลั arm | ~/Humanoi/scripts/arm.sh (alias ใน ~/.bashrc ) · ลำ ดับดั calibrate ตั้งที่ LEFT_CAL_ORDER / RIGHT_CAL_ORDER

เปิด MoveIt | ~/Humanoi/scripts/arm_moveit.sh

คู่มืคู่ อมื | ~/Humanoi/docs/AR4_ARM_COMMANDS.md และไฟล์ PDF นี้

Teensy สองแขน | หาเองจากชื่อที่เก็บในบอร์ดร์ ( arm ports ) · บังบั คับคั เองได้:ด้ LEFT_TEENSY=... RIGHT_TEENSY=... arm start

Arduino Mega (ฐาน) | /dev/serial/by-id/usb-Arduino__www.arduino.cc__0042_858303033393517150C0-if00
