Thenine2077/humanoi/docs/calibration/aruco_handeye_id0.html

# ป้ายคาลิเบรตกล้อง-แขน (hand-eye) — ArUco DICT_4X4_50 id 0

40 mm (ค่าเริ่มของเครื่องมือ)

40 mm (สำรอง)

60 mm — ใช้ถ้าติดที่มือได้ (อ่านแม่นกว่า): ใส่ marker_size:=0.06

1. สั่งพิมพ์แบบ ขนาดจริง / Actual size / 100% (ปิด "Fit to page") แล้ววัด: ด้านสี่เหลี่ยมดำต้องได้ 40 mm / 60 mm และแถบด้านล่างยาว 100 mm — ไม่ตรง ใส่ค่าที่วัดได้จริง เช่น marker_size:=0.0385
2. ตัดตามเส้นเทาอ่อน — เหลือขอบขาวไว้ (โปรแกรมต้องเห็นขอบขาวรอบกรอบดำ)
3. แปะบนแผ่นแข็ง (ฟิวเจอร์บอร์ด/อะคริลิก) ให้เรียบ แล้วยึดกับมือหรือข้อมือแน่น ห้ามโยก ระหว่างคาลิเบรต
4. ตำแหน่งบนมือไม่ต้องวัด — โปรแกรมคำนวณเอง · ใช้แผ่นเดียว (id 0 ซ้ำกันห้ามให้กล้องเห็นพร้อมกันสองแผ่น)
