Thenine2077/humanoi/docs/calibration/aruco_tray_id1_120mm.html

# ป้ายถาด Humanoi — ArUco DICT_4X4_50 id 1 · ด้านดำ 120 mm

1. สั่งพิมพ์แบบ ขนาดจริง / Actual size / 100% (ปิด "Fit to page")
2. วัดด้านสี่เหลี่ยมดำ ต้องได้ 120 mm และแถบด้านล่างต้องยาว 100 mm — ไม่ตรง แจ้งค่าที่วัดได้ (เคยพิมพ์ออกมา 94%)
3. ตัดตามเส้นเทาอ่อน (เหลือขอบขาวรอบป้าย 20 mm — ห้ามตัดขอบขาวทิ้ง) แปะเรียบกลางพื้นกล่อง ห้ามงอ/ยับ
4. แปะแล้วห้ามย้าย (ท่าจับสอนเทียบป้าย) · ด้านบนของป้าย (หัวกระดาษ) หันไปทางหุ่น
