Thenine2077/humanoi/docs/calibration/checkerboard_9x6_25mm.html

Checkerboard 9×6 (มุมด้านใน) · ช่องละ 25 mm — พิมพ์แบบ Actual size / 100% (ห้ามเลือก Fit to page) · ตรวจด้วยไม้บรรทัด: 10 ช่อง = 250 mm · ติดบนแผ่นแข็งที่เรียบ (ลังกระดาษ/อะคริลิก) ห้ามโค้งงอ — ขอบขาวรอบตารางต้องเหลือไว้ · ใช้กับ ros2 launch humanoi_vision calibrate_color.launch.py
