Thenine2077/humanoi/(commit log)

2026-10-15 Humanoi: mecanum base + Pi ROS 2 stack (initial import)
    Base firmware (Mega + FlySky + arm switches), ROS 2 packages (base, description,
    nav, teleop, rc_arm_trigger), Pi Docker image with MoveIt, arm helper scripts,
    docs (Pi setup, AR4 arm manual, power budget). Third-party ldlidar_ros2 and
    rf2o_laser_odometry are vendored; see THIRD_PARTY.md.
    [arm_controllers.yaml, empty.sdf, humanoi_full.srdf.xacro, humanoi_full.urdf.xacro, mecanum_base.urdf.xacro, power_budget.xlsx, room.sdf, room_obstacle.sdf]
2026-10-19 Camera calibration, YOLO 3D + hand-eye, dual-arm arm.sh
    - humanoi_vision (new): yolo_node (Hailo YOLO -> 3D points from registered
    depth, +3 cm depth offset, table-plane fallback for objects too close for
    the depth sensor), calibrate_color, check_depth_scale, hand_eye_calibrate
    (ArUco marker on the hand, eye-to-hand, publishes camera TF from yaml).
    - humanoi_description: astra_color.yaml lens calibration (fx 632),
    camera_to_left_arm.yaml hand-eye result (rms 7.1 mm), camera.launch.py
    turns on depth registration and loads the lens file.
    - scripts: hailo_yolo_server.py + systemd unit, yolo_view / calibrate /
    hand-eye helpers; arm.sh rewritten for two arms (ports found by arm name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
2026-10-19 Arm manual: update for two arms
    AR4_ARM_COMMANDS.md and the PDF manual (rebuilt from
    docs/manual/AR4_ARM_MANUAL.html) now cover the dual-arm commands:
    first-time setup (VBUS back-power check, arm ports, arm identify,
    calibration order, arm dir), per-arm teach/goto/delete, "<left>/<right>"
    program steps with "-" = hold still, arm show, per-arm joint-by-joint
    calibration and its output, MoveIt planning groups, the PC dual-arm sim,
    and the rule to switch arm power off before plugging or unplugging USB.
2026-10-19 Add arm_pc.sh: same arm commands on the PC (WSL)
    Runs ROS directly in WSL and talks to the Teensys through Windows
    python.exe (ports/name/dir/identify/calibrate) and a COM->TCP->socat
    bridge for arm start (/tmp/ttyV_left|right, bound to the WSL host IP
    only, torn down on exit or by arm off). Adds arm start sim and
    documents PC use in AR4_ARM_COMMANDS.md section 6.
2026-10-20 Add humanoi_games: rock-paper-scissors with the left arm and AmazingHand
    rps_game: ready pose (rps_ready) -> J1 up/down x3 within firmware accel
    limits, picking the "up" sign from TF -> hand reveals a random choice on
    the last beat -> player's hand voted from /rps/player_gesture -> thumbs
    up if the player wins, V + snip if the robot wins, replay on draw.
    Triggered by /rps/play (Empty), so any caller can be added later.
    amazinghand_node owns the hand bus (rustypot) and refuses torque unless
    all 8 servos answer at 4.8-7.4 V. rps_vision classifies rock/paper/
    scissors with MediaPipe 1.1.1 (installed --no-deps to keep numpy 1.26).
    arm rps / arm rps play / arm rps stop on the Pi and PC helpers;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
2026-10-20 amazinghand_node: find the servo baud rate instead of assuming 1 Mbps
    On 2026-10-20 the hand answered only at 250000 (the seller's setting)
    although it had been moved to 1 Mbps earlier, so the preflight saw no
    servo at all. Try the configured baud first, then the others, read-only;
    warn when it differs. Verified on the real hand on the Pi.
2026-10-20 rps game: faster, smaller pump; loose wind-up hand, tight-fist rock
    The user found the pump slow and rock hard to tell from the fist held
    while pumping. J1 is capped by the firmware (JOINT_MAX_ACCEL 10 deg/s^2),
    so the pump goes to 5 deg at 0.17 rad/s^2 (11.6 s -> 8.6 s) and the
    player window to 1.2 s. The hand now holds a loose "windup" pose while
    pumping; "rock" is the tightest fist (measured contact angles - 4 deg).
    arm rps passes key:=value through, e.g. arm rps camera pump_deg:=4.
    [hand_poses.py, rps_game.py]
2026-10-20 rps game: show poses before the hand, and point a finger to play again
    After the result the arm first moves to victory_pose (robot wins) or
    lose_pose (robot loses), both taught by the user and optional, then the
    hand does V/thumbs-up as before; the arm stays there. After a finished
    game, holding up one index finger (rps_vision now reports "point") for
    replay_hold 0.8 s starts the next game from the ready pose, looping;
    the wait lasts replay_timeout (60 s, 0 = forever) and /rps/stop ends it.
    Tested with mock arms: pose reached before the hand gesture, replay
    triggers on a held point but not on a 0.4 s blip.
2026-10-20 rps game: lose sequence alternates the show poses; return via ready_pose
    On a loss the arm now goes victory_pose -> lose_pose three times
    (lose_moves / victory_moves are space-separated pose lists), then the
    hand gives the thumbs-up. Near show poses (<=45 deg apart) move at the
    firmware ceiling (0.22 rad/s, 0.17 rad/s^2): a 39 deg swing takes 4.4 s.
    The user found the direct swing back to the ready pose too much for J1,
    so after the show, and at game start when far from rps_ready, the arm
    follows the left-arm steps of the taught program ready_pose first.
    Checked in sim with the Pi's programs.yaml.
    [rps_game.py]
2026-10-20 rps game: return path is move_readyP1 -> move_readyP2 -> rps_ready
    The user wants the way back without Calibrate_fin_L, so the route is now
    the game's own pose list (return_moves) rather than the ready_pose
    program, which stays as the user's start-up program. Sim with the Pi's
    programs.yaml: return takes ~25 s instead of ~36 s.
2026-10-20 humanoi_games: hand_calibrate for MiddlePos, loaded by the hand node
    The user found the hand poses odd: MiddlePos was still the demo hand's.
    hand_calibrate (arm hand-calibrate on the Pi) works finger by finger by
    eye: the finger under test stands straight while the others curl, and
    l/r tilt, f/b bend, 1+/2- nudge one servo, o/c preview open/closed.
    Port and baud are found and the voltage is checked as in the node.
    Values go to src/humanoi_games/config/middle_pos.json, which
    amazinghand_node reads at start (demo values if the file is missing).
    [amazinghand_node.py, hand_calibrate.py]
2026-10-20 hand_calibrate: allow MiddlePos up to +-60 deg, clamp targets at +-140
    On the real hand the index finger needed more than the +-30 deg cap to
    stand straight (horns probably two spline teeth off). The cap is now
    +-60 in both the tool and the node's loader. Gesture targets are clamped
    to +-140 deg (factory limit +-144) with a warning, since a large
    MiddlePos plus the tight fist would otherwise go out of range.
    [amazinghand_node.py, hand_calibrate.py]
2026-10-20 hand_calibrate: --reset starts over from the demo MiddlePos
    The user found mechanical play in the finger and wants to calibrate from
    scratch. --reset renames the saved file to .bak-<time> (nothing deleted)
    and starts from the demo values; quitting with x leaves the game on them.
    [hand_calibrate.py]
2026-10-20 hand_calibrate: per-finger tightest close and widest open
    The user's MiddlePos turned out far from the demo hand's (straight
    fingers needed up to ~57 deg of bend offset), so fixed close/open angles
    made the gestures look wrong. Each finger now also gets a calibrated
    close (c, +/-: until the tip meets the palm) and open (o, +/-).
    hand_poses uses tags C / O / L (halfway) per finger; rock = tightest
    close, paper = widest open, windup = halfway, folded fingers in other
    gestures = close. The node loads close/open from the same file
    (missing = demo 90 / -35).
    [amazinghand_node.py, hand_calibrate.py, hand_poses.py]
2026-10-20 hand_calibrate: per finger only open, close and tilt
    The user found the straight/close/open steps confusing and asked for
    just widest open, tightest close and tilt per finger. The calibration
    is now {finger: {open, close, tilt}} in servo degrees; the old
    middle_pos file is converted on load with identical servo targets, and
    no file reproduces the Pollen demo exactly. The tool starts each finger
    at open (+/- and l/r), c goes to close (+/-), n saves and moves on.
    V / pointing gestures are open plus an extra spread.
    [amazinghand_node.py, hand_calibrate.py, hand_poses.py]
2026-10-20 hand: take angle limits from each servo, not a hard-coded +-140
    The user asked how a fixed limit in the code can be trusted. Hand.connect
    now reads every servo's min/max angle limit from its EEPROM (read-only),
    prints them, and uses them for clamping and for the calibration checks;
    an unreadable or implausible reading falls back to the factory +-144 deg
    with a warning. The arbitrary 20 deg open/close gap is gone (only
    close > open remains), a refusal names the servo, the target and its
    range, and values already outside can still be moved back inside.
    [amazinghand_node.py, hand_calibrate.py]
2026-10-20 hand_calibrate: show .5 values exactly and the finger's servo angles
    Values converted from the old file end in .5, so rounding made +5 look
    like steps of 4 and 6. The prompt now prints them unrounded and adds
    both servos' target angles for the current pose, so the user can see
    how close a finger is to its servo limits.
2026-10-21 docs: AmazingHand guide and current status
    How the hand is wired and powered, what amazinghand_node checks before
    moving, how finger angles and gestures are computed, how to calibrate,
    the open problems (finger play, horns likely off by teeth, calibration
    unfinished, servo limits read from EEPROM not yet verified, baud back
    at 250000, Pi USB ports full) and the progress so far.
2026-10-21 arm: hand gestures in programs, arm hand, player starts the hand driver
    arm program steps take optional hand slots:
    <left arm>/<right arm>[/<left hand>[/<right hand>]] with English gesture
    names (rock paper scissors point like windup victory nonono relax).
    arm player now launches humanoi_games player.launch.py (ar_program
    player + amazinghand_node; nohand = dry run, always dry run on the PC),
    arm hand <gesture> [left|right] tries a gesture and first checks that a
    hand driver is listening, and arm player / arm rps refuse to run
    together since they share the arm and the hand port.
2026-10-21 hand_teach: jog or hand-bend fingers and save named hand poses
    arm hand-teach (Pi) selects a finger with 1-4, jogs bend/tilt with +/- l/r,
    or frees fingers so they can be bent by hand, then saves the pose into
    programs.yaml hand_poses. amazinghand_node reads taught poses on every
    command (no restart) and lets them override built-in gestures, so the
    RPS game uses them too. arm hand accepts taught names; hand-teach,
    hand-calibrate and player refuse to share the hand port.
    [arm_controllers.yaml]
2026-10-21 hand: stop pushing fingers that can't reach their target
    Taught poses drove servos to +-143 (servo end) far past where the
    fingers hit the palm. The servos' unloading condition (overload) then
    cut their own torque, leaving fingers limp for every later gesture.
    - Hand.settle/stuck: after a move, wait until still; a servo more than
    8 deg off its target is held where it stopped and reported
    - amazinghand_node: re-enable torque each gesture (warn if a servo had
    unloaded), check each settled pose, new commands interrupt the check
    - hand_teach: same check after every jog so saved poses are reachable;
    load moves at the playback speed to preview arm hand / the game
    - AMAZINGHAND.md: notes, li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
    [amazinghand_node.py, hand_teach.py]
2026-10-21 hand: survive servo read timeouts and mid-move resets
    On the real hand, load rock (all fingers moving into a stall at once)
    made five servos reset (goal speed back to 0, torque off) and a read
    timed out, which crashed hand_teach.
    - Hand.read_degrees / unloaded retry a few times; settle skips the
    check instead of raising
    - after a move, servos whose torque dropped are reported as a power
    dip and re-enabled where they are (teach and node)
    - hand_teach: a failed command prints an error and keeps the session
    [amazinghand_node.py, hand_teach.py]
2026-10-21 hand: name the servo ID when a read keeps timing out
2026-10-21 hand: arm hand-side to switch between the right and left hand kits
    Both AmazingHand kits answer as servo IDs 1-8, so the mounted kit is
    set by hand (arm hand-side left|right, stored in config/hand_side).
    The node, hand_teach and hand_calibrate pick the kit's calibration file
    (middle_pos.json / middle_pos_left.json), taught poses (hand_poses /
    hand_poses_left) and spread direction from it. rps hand_side and the
    node side param default to auto.
2026-10-21 rps: status screen for players in Foxglove (rps_hud)
    New node rps_hud renders /rps/hud/image/compressed: ROUND BEGIN, a
    3-2-1 countdown with a bar synced to the arm's real pump beats, SHOOT!
    with the robot's move, YOU WIN / YOU LOSE / DRAW / NO HAND SEEN with
    both moves, PLAY AGAIN? with the seconds left, TIME OUT, and a running
    score. It draws only while someone is subscribed; Pillow + DejaVu, with
    an OpenCV fallback.
    rps_game /rps/state now carries what the screen needs:
    pump:<try>:<beat times>, result:<res>:<robot>:<player>,
    waiting_replay:<seconds>.
2026-10-22 vision: tray_detector finds the box from an ArUco marker on its floor
    For the A-to-B tray demo. The box sits closer to the Astra than its
    ~0.6 m depth minimum, so the pose comes from the color image only
    (IPPE_SQUARE PnP on a 120 mm 4x4_50 id 1 marker), averaged over 0.6 s
    with jump rejection, and published only when steady and not edge-on.
    - tray.py: pure-numpy pose, averaging, tilt and turn helpers
    - tray_detector: /tray/pose (camera frame), /tray/pose_arm via the
    hand-eye TF, /tray/status, TF tray_marker, debug image for Foxglove
    - tray.launch.py: camera + hand-eye static TF + detector
    - launch_tools.camera_tf shared with yolo.launch.py
    - docs/calibration: printable marker (A4, scale b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
2026-10-22 docs: printable hand-eye marker sheet (ArUco id 0, 40 and 60 mm)
2026-10-22 hand_eye_calibrate: save raw samples (.samples.npz) and log the worst poses
    A rejected run (34 mm rms) left nothing to analyse; now every result
    keeps the camera points and link_6 poses next to its yaml.
2026-10-22 hand_eye_calibrate: process 5 frames/s and show the window at native size
    It ran at 100% of a core for hours (ArUco + 960x720 resize on every
    30 fps frame) and made the Pi lag. The arm must be still to capture
    anyway, so 5 Hz loses nothing. New param rate (default 5).
2026-10-22 vision: tray_teach calibrates camera-to-arm by teaching box grasps
    The marker-on-hand hand-eye needs poses all over the image, which the
    left arm can't reach without overloading joint 1. Instead the user
    jogs the hand onto the box handle 6-8 times with the box shifted
    (~5 cm in two directions, +-15 deg). Each grasp gives
    A (link_6 in arm base) = X (camera) * C (marker seen) * Y (grasp on
    marker); solve_grasp_camera finds X and Y together (Kabsch start,
    Gauss-Newton on 12 params) and flags one-direction data.
    Synthetic Monte Carlo (2 mm / 1 deg teach noise): new placements
    predicted within ~3-5 mm median, p90 6.5 mm with 8 grasps.
    Writes camera_to_<arm>_arm.yaml (used by tray.launch.py) and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
2026-10-22 arm tray: refuse when another program already holds the camera
2026-10-22 tray_teach: contact-point model so the wrist may tilt per grasp
    On the real arm the hand can't reach every box placement with the
    same wrist angle, so the fixed-grasp model (A = X C Y) left 4-13 deg
    and ~10 mm residuals. Now only a point on the finger p (link_6) must
    touch the same point on the handle q (marker): A p = X C q, solving
    X, p, q (12 unknowns, >= 5 grasps). At pick time the nearest taught
    grasp (wrist pose relative to the marker) is moved with the marker.
    Synthetic, 7 grasps with +-12 deg wrist tilt: wrist error median
    4.6 mm, p90 7.2 mm. Height along the table normal stays ambiguous
    (harmless on the same table).
    Also: every capture/delete autosaves raw data to
    config/tray_teac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
2026-10-26 tray_teach: calibrate by touching, then record real grasps with g
    The user can touch a marked spot on the box side with the pointing
    index fingertip (sharper and quicker than hooking the handle), but
    those touch poses must not become the pick grasps. Touches (Enter)
    now only calibrate the camera; real grasps (fingers in tray_grip on
    the handle) are recorded with g after calibration and are the only
    entries in tray_grasp_<arm>.yaml. w without grasps writes the camera
    file only. Grasps autosave and reload with the touches.
2026-10-26 hand: use the adapter that has servos; add arm hand-scan
    A second Waveshare board (for the right hand, no servos yet) appeared
    on the hub and "auto" picked it first, so the left hand was "not
    found". Hand.connect now tries every CH343 board and keeps the first
    one whose servos answer (the failure message lists every board tried).
    arm hand-scan (humanoi_games/hand_scan.py): read-only check of every
    hand board: which IDs answer, at which baud, and their voltage
    (flagging values outside 4.8-7.4 V). It replaces tools\scan_servos.py
    on the Pi.
    [amazinghand_node.py, hand_scan.py]
2026-10-26 tray_teach: stop the executor thread before destroying the node
    Quitting printed 'exception was never retrieved: cannot use
    Destroyable because destruction was requested'. Data was already
    saved; this just makes the exit clean.
2026-10-26 tray_teach: weak hand-size prior on the touch point
    With few rotated touches the touch point on the finger is barely
    observable and the fit wandered to 3-5 m from the wrist (residuals
    looked fine but meant nothing). The solver now takes a soft prior
    (touch_prior, default 21 cm along link_6 z = AmazingHand length +
    mount, +-5 cm) so the report shows a real number and a bad touch
    stands out. Real data 10-26: touches 1-5 + the post-calibration check
    fit at 7.3 mm with the fingertip at 25 cm; the suspect touch 6 pulls
    it to 48 cm.
2026-10-26 tray_teach: shortcut mode - teach real grasp + compensate box shift
    Touches with the wrist at a fixed angle give only the camera direction
    (wrist shift = R * marker shift), not its position. That is all a taught
    grasp needs to follow a box that slid a few cm: wrist = taught grasp +
    R * (marker now - marker at teach), same wrist angle.
    - tray.same_wrist_touches picks the largest group of touches with the
    same wrist angle and an unturned box; others are reported, not used
    - tray.delta_rotation (Kabsch) + leave-one-out wobble as quality figure
    - tray.delta_grasp moves a taught grasp to the new marker pose
    - report predicts grasp 2.. from grasp 1 to measure the real accuracy
    - w writes tray_g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
2026-10-26 arm zero / trim check at arm start; calibrate goes to the straight pose
    - arm zero <arm>: write ar_dual/config/zero_trims.yaml into the board
    - arm start refuses when a board's zero trims differ from the file
    (e.g. after reflashing), so taught poses never land 19 deg off
    - arm calibrate passes --arm, so the joints listed in after_calibrate
    turn to their straight pose when calibration finishes
    - rps_game checks poses against the arm's own (trimmed) limits
2026-10-26 tray_pick: pick the box where the camera sees it, from the taught grasp
    arm tray-pick: Enter shows the plan (no motion), y executes, r puts the
    box back. Grasp = nearest taught grasp shifted with the box
    (tray.delta_grasp); refuses beyond max_shift_m / max_turn_deg.
    Steps: fingers tray_grip0 -> joint move to the hover point above the
    grasp -> straight line down -> fingers tray_grip -> straight line up.
    - arm_chain.py: FK / damped-least-squares IK / straight lines from the
    live robot_description (zero offsets and trimmed limits included), so
    MoveIt is not needed; FK is checked against TF before every plan
    - hover and lift heights are whatever the straight line reaches (J5 runs
    into its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
2026-10-26 tray_pick: h <cm> raises the grasp point above the taught one
    The first real pick held the lip a little low. The grasp file now has
    grasp_offset_up (m, along the box normal); tray_pick applies it to the
    wrist target and shows it in the plan. "h 0.5" in arm tray-pick stores
    it, "h" shows it. tray_teach keeps the value when it rewrites the file.
2026-10-26 docs: arm zero trims + tray pick summary; snapshot of the Pi's taught data
    - docs/ARM_TRAY_PICK.md: zero trims (both arms), shortcut tray teach,
    tray pick usage, results so far and open items
    - tray_grasp_left.yaml / tray_teach_left.captures.npz: the grasps and
    touches taught on the Pi (grasp_offset_up 0.5 cm)
    - humanoi_games/config: hand_side (left kit) and the hand calibration
    [tray_grasp_left.yaml]
2026-10-26 Full-robot Gazebo sim: shared upper body, simulated camera, measured base
    - humanoi_full.urdf.xacro / srdf use ar_dual's humanoi_upper.xacro and
    arm_control.xacro (same arms, hands and controllers as the real robot)
    - simulated Astra Pro bridged to the real driver's topic names
    (/camera/color/image_raw, camera_info, depth, points)
    - mecanum base dimensions measured
    - moveit_full / sim_with_arm launch updated; run_humanoi_gz.bat opens
    Gazebo, MoveIt + RViz and the program player in WSL
    [humanoi_full.srdf.xacro, humanoi_full.urdf.xacro, mecanum_base.urdf.xacro]
2026-10-26 Reach the Pi by hostname; no core dumps from the container
    - docs, launch hints and sync_to_pi.sh use EIT-Raspberry-Pi-5.local
    instead of the old 192.168.1.68 (the IP changes)
    - docker-compose: ulimit core 0 - Jazzy's move_group / ros2_control_node
    / rviz2 crash on exit and left ~400 MB core files in ros2_ws (6.2 GB)
2026-10-26 README: project overview written as a showcase
    What the robot is and what it already does (rock-paper-scissors, programmed
    gestures, picking a box by camera, mecanum base, YOLO on Hailo, digital
    twin), hardware, system architecture (mermaid), the interesting engineering
    behind it, status / next steps, code layout of both repos, and only then
    how to run it. Photos in docs/images.
2026-10-27 Two AmazingHands: each arm's hand bound to its board by serial number
    Both kits are servo IDs 1-8 and the ttyACM order changes on every plug,
    so "first board whose servos answer" could drive the right hand from the
    left arm's commands.
    - config/hand_boards.yaml: left -> board 5B91044327 (left kit),
    right -> 5B91030501 (right kit); Hand port "arm:<arm>" looks the board
    up by serial at every connect and opens nothing else
    - amazinghand_node: arm param; topics /hand/* (left) and /right_hand/*
    (right); kit from the file. arm player starts one node per arm
    - rps_game publishes to the hand of the arm it plays with
    - hand-teach / hand-calibrate take [left|right]; hand-scan shows which
    arm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
2026-10-27 hand_calibrate: other fingers open, not closed, while one is set
    Closed neighbours got in the way of the finger being calibrated. Now the
    whole hand starts open and only the finger in its "close" view bends.
2026-10-27 arm.sh: arm recal / arm reconnect for one arm while the other runs
    - arm start caches the resolved Teensy ports in the container
    - arm recal <arm> [order]: stop that arm's controller manager, calibrate
    it (cached port, board name checked), check zero trims, restart it
    - arm reconnect <arm>: same without calibrating
    - arm calibrate works with the system up if that arm's CM is stopped
    - status lists each arm's controllers; off also stops the per-arm nodes
    - docs: AR4_ARM_COMMANDS section for the new workflow
2026-10-27 humanoi_games: hand calibration snapshot from the Pi (right kit + first left-kit calibration)
2026-10-27 arm.sh: recal checks the joint order before stopping the arm; Ctrl+C after the stop says how to reconnect
2026-10-27 base: 4 wheel encoders on the Mega -> wheel feedback in ROS + wheel speed tuning tool
    - humanoi_base_mega: YT3806 encoders on A8-A15 (PCINT2, x4 or x2 decode),
    "ENC t c1..c4 e1..e4" every 50 ms, "Z" zeroes counts; RC pulses now read
    with pulseInLong so encoder interrupts don't shorten them
    - relay_bridge: /wheel_states, /wheel_odom (mecanum forward kinematics,
    TF off by default), /encoder_raw; /wheel_cmd drives the 4 wheels directly;
    encoder_map/encoder_signs/counts_per_rev params; config/base.yaml
    - wheel_tune: `check` spins one wheel at a time to find encoder_map/signs
    (saves to base.yaml), `tune` shows live per-wheel rpm with which knob to
    turn up/down
    - arm.sh: arm base / whe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
    [base.yaml, humanoi_base_mega.ino, relay_bridge.py, wheel_tune.py]
2026-10-27 encoders: 24V supply + 10k/2.2k divider per signal line; PC live viewer tools/enc_live.py
2026-10-28 Base moves by distance with a lidar guard; mission runner for the A -> B demo
    - humanoi_base/base_motion: drive forward/back/left/right X m or turn X deg,
    then stop (odometry: /wheel_odom from encoders, /odom in sim); lidar
    corridor guard pauses while something is in the way, gives up after
    block_timeout; stops on stale odom/lidar, RC takeover, or stop request
    - base_move CLI (arm drive), arm lidar (STL-19P + static TF)
    - humanoi_mission: steps from config/missions.yaml (confirm, program, hand,
    pick, place_back, move, wait); validates every pose/program/grasp file
    and running node before starting; base moves only with both arms in a
    stow pose; SWB confirms, SWD or Ctrl+C stops ba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
2026-10-28 Measured base size: 53 x 42.5 cm, wheels 14.5 cm x 4 cm
    - track = 42.5 - 4 = 38.5 cm, wheelbase = 53 - 14.5 = 38.5 cm (wheels are the
    outermost points), wheel radius 0.0725
    - mecanum_base.urdf.xacro, relay_bridge defaults + config/base.yaml (odometry),
    lidar guard footprint 0.265 / 0.2125 m, nav2 robot_radius 0.35
    - lidar position is still the 0.16 m guess
    [mecanum_base.urdf.xacro]
2026-10-28 Mapping without encoders: arm map / arm map-save, lidar self-hit mask
    - scan_mask: drops lidar points inside the robot footprint (+3 cm) — the pole
    sits 10-18 cm behind the lidar in its plane and would make rf2o think the
    robot stands still; lidar.launch.py now publishes scan_raw -> scan_mask -> scan
    (mask:=true by default, lidar_x arg shared with the static TF)
    - real_slam.launch.py: starts foxglove_bridge as a node (including the XML
    launch from Python passes port as a string and the bridge aborts)
    - arm map: lidar (by-id) + scan_mask + rf2o + slam_toolbox + Foxglove;
    arm map-save <name> -> humanoi_nav/maps/<name>.pgm/.yaml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
2026-10-28 Encoders on one 4-channel opto board: A wire only, direction from the relays
    - firmware: ENC_B_WIRED = false counts every edge of A (720/rev) and takes the
    sign from the wheel's last relay command (keeps it while coasting);
    READY reports enc=a2 / x4 / x2
    - relay_bridge warns when counts_per_rev doesn't match the firmware mode;
    base.yaml counts_per_rev 720
    - docs: wiring for a single 4-channel opto board (IN1-4 = green wires,
    OUT1-4 = A8 A10 A12 A14)
    [base.yaml, humanoi_base_mega.ino, relay_bridge.py]
2026-10-28 arm wheel-tune: optional run time (e.g. 3s) for tuning on the floor
2026-10-28 base: encoder_map from wheel-check on the real base (FL/RR wires swapped)
    [base.yaml]
2026-10-28 wheel-tune both: alternate forward/back, tune the two-direction average
    Motors run at different speeds forward and backward but one knob sets both,
    so the knob is tuned on the average and the per-direction spread is reported.
2026-10-28 wheel-tune both: measure both directions once, then live-tune forward to per-wheel targets
    Alternating forward/back took ~10 s per reading, too slow for turning knobs.
    Now one 3 s + 3 s measurement gives each wheel's back/forward ratio, the
    per-wheel forward target that equalises the two-direction average, and then
    the usual 1 s live forward readout against those targets.
    [wheel_tune.py]
2026-10-29 Base lidar guard enforced on the Mega for both remote and ROS driving
    relay_bridge reads /scan, works out which directions (forward, back, left,
    right, turn) have something within 0.30 m of the base outline, and sends
    "G <bits>" to the Mega every 50 ms. The Mega works out where the current
    wheel command (remote sticks or ROS) would move the base and stops all
    wheels if that direction is blocked, so moving away is still allowed.
    No /scan means every direction is blocked. If the Mega stops hearing the
    Pi for 0.5 s it blocks everything until SWA is flipped up and down.
    `arm base noguard` / `arm remote ... noguard` turn it off for bench work.
    tools/mega_sim builds the real Mega firmware as a Li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
    [base.yaml, base_motion.py, guard.h, guard.py, humanoi_base_mega.ino]
2026-10-29 Lidar height 23.5 cm (measured), guard test teardown fix
    - lidar.launch standalone TF and mecanum_base.urdf.xacro lidar_z = 0.235
    - BASE_SAFETY.md: what a 23.5 cm scan plane can and cannot see
    - test_guard_e2e.py: join the spin thread before rclpy shutdown (aborted
    at exit on the Pi even though all checks passed)
    [mecanum_base.urdf.xacro]
2026-10-29 Lidar sits 17.5 cm ahead of the base centre (measured, was a 16 cm guess)
    Measured on the robot: lidar centre to base plate front edge 2.5 cm, rear
    37.5 cm (left 15.5, right 15 — 2.5 mm off centre, ignored). One constant
    LIDAR_X in base_motion now feeds the no-TF fallbacks of base_motion, the
    guard and scan_mask; lidar.launch and the xacro carry the same value.
    [mecanum_base.urdf.xacro]
2026-10-29 arm lidar-check: measure lidar yaw and catch a mirrored scan
    The lidar pose now lives in one file, humanoi_base/config/lidar_mount.yaml
    (x, y, z, yaw_deg). lidar.launch takes its static TF and scan_mask
    defaults from it, and the guard and base_motion use it when there is no TF.
    lidar_check: a narrow upright object on the base centreline about 1 m
    ahead must show at 0 deg in the raw scan; any offset is the mounting yaw
    and is saved to lidar_mount.yaml. Moving the object to the robot's left
    must make new points appear at a positive angle; otherwise the scan is
    mirrored, which would make the guard block the wrong side, and nothing is
    saved. A 5 s countdown lets the operator step out of the sca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
    [mecanum_base.urdf.xacro]
2026-10-29 arm help: coloured sections, per-topic help, unknown-command hint
    - Commands regrouped into 10 sections (setup, arm, teach, play, hand,
    tray, base, lidar, mission, rps) with bold coloured headers, green
    command names and yellow warnings; colour only on a terminal (NO_COLOR
    respected) so piping stays plain.
    - `arm help <topic>` shows one section (Thai aliases work: ฐาน, มือ ...).
    - Unknown commands no longer dump the whole help: they say so, list
    commands with the same prefix, and exit 1.
    - Description column aligned by display width (Thai combining marks
    take no column). `arm help` works without the container running.
    - Added the J1-drops-on-power-off and 7.4 V hand ser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
2026-10-29 Printable Humanoi manual (A4 HTML book) with image placeholders
    docs/manual/HUMANOI_MANUAL.html: 14 chapters (overview, safety, Pi/Docker,
    start-up and remote, arms, teaching, hands, tray pick, base, lidar, guard,
    mission, RPS game, troubleshooting) plus appendices built from `arm help`,
    config file locations, the Pi<->Mega protocol, and the list of pictures
    still to take. Prints from the browser (A4, page numbers, chapter breaks).
    49 picture slots load docs/manual/img/<name>.jpg or .png when the file
    exists and otherwise print as dashed boxes describing what to shoot
    (img/README.txt lists them). Open questions are marked "ต้องเช็ก" and can
    be hidden before printing.
    Source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
2026-10-29 arm broke / arm j1-load commands, arm speed cap 0.19 in RPS game and docs
    - arm.sh: `arm broke <kind> [arm] [jN] [note]`, `arm broke list|report`,
    `arm j1-load [arm]`, new help topic `log`, motion_log in status/off
    - rps_game: show/pump speed and MAX_SPEED 0.19 (board now caps J1 at 11.25 deg/s)
    - docs + manual: J1 load section, incident logging before recal, speed table
    (MoveIt scaling 1.0, J1 board limit), rebuilt HUMANOI_MANUAL.html
    [rps_game.py]
2026-10-29 rps: robot win = finger wag (nonono) in arm help and result text
    rps_game has used lose_pose + nonono for a robot win since 17aff97, but
    arm help, the arm rps play result line (arm.sh, arm_pc.sh) and the
    AMAZINGHAND.md gesture table still said "two fingers" / victory.
2026-10-29 Manual: 12 checks resolved from code and the Pi, what-runs-where diagram, first photos
    - Resolved from code / the Pi (19 -> 7 open checks): per-arm joint limits
    match programs.py + zero_trims.yaml, fist in the gesture table, demo_ab
    return still uses back, sync overwrites middle_pos*.json (+ scp commands
    to pull Pi data back), container still on the 14 Oct image, hand board
    5B91044327 = left arm / left kit, other fingers open during
    hand-calibrate, right hand in programs, tray-teach needs arm player for
    tray_grip and a re-teach after the camera moves, robot win = nonono
    - Inline SVG diagram: PC / Pi host / container humanoi_ros + USB devices;
    RViz runs in the container and show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
2026-10-29 camera_to_left_arm.yaml: snapshot from the Pi (tray_teach fit, 22 Oct)
2026-10-30 Show controller: arm show / arm up for the A -> B box-pick show
    humanoi_mission show.py runs a show (config/shows.yaml) one round at a
    time for an operator: SWB = start / confirm / resume, SWD = stop (again =
    end round), Enter / s / q on the keyboard, /show/cmd. A stopped drive
    resumes with only the remaining distance; steps take retry / optional /
    prep; every round is checked first and logged to arm_logs/show-DATE.jsonl;
    state is published on /show/state.
    New steps on top of mission: say, route (legs from routes.yaml), dock
    (base_motion.approach drives forward until the lidar front gap reaches
    the saved distance; the guard lowers its forward stop via
    /base_guard/dock while docking) and und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
2026-10-30 docs: system wiring diagram (PDF + PNG preview), linked from README
    Pi 5 + USB hub (arms, hands, camera, lidar, Mega), FlySky receiver,
    16-relay board, 4 motors + encoders through the opto board, 24 V supply.
    Drawn by the user in VectorCraft; the PNG is a 2400 px render for GitHub.
2026-10-30 Manual: system wiring diagram in the overview chapter
    Figure 1.3 is a 3000 px render of docs/SYSTEM_WIRING.pdf, with a pointer
    to the full PDF for pin-level zoom. The diagram draws the hand boards'
    supply straight from the 24 V PSU, so a warning says the hand servos must
    not exceed 7.4 V and a new check asks which step-down feeds them on the
    real robot (POWER_SYSTEM plans a 6 V XL4016).
2026-10-30 Wiring diagram: hand boards on their own 5 V supply
    The user's updated diagram adds a separate 5 V DC supply for both hand
    boards (previously drawn from the 24 V PSU). Manual figure 1.3 and the
    README row follow; the 24 V warning and its open check are replaced by a
    note that the hand runs on 5 V and the node refuses torque outside
    4.8-7.4 V (7 open checks again).
2026-10-30 show_setup route-record: wait for the first lidar scan before measuring the start gap
    On the Pi the start gap was measured before any scan had arrived, so
    approach for the start table was never saved (WSL starts slower and
    happened to pass). Found by the mock suite in the Pi container, 26/26 now.
2026-10-30 Wiring diagram: part labels and Mega GND to the opto board
    Updated by the user: labels for depth camera, lidar, AR4, HW-687, DC motor,
    encoder and opto board; the Mega GND to the opto board is rerouted.
    Re-rendered the README PNG and manual figure 1.3.
